wellytomOC/TCC/Figuras/Resultados/TelaResultados.jpeg

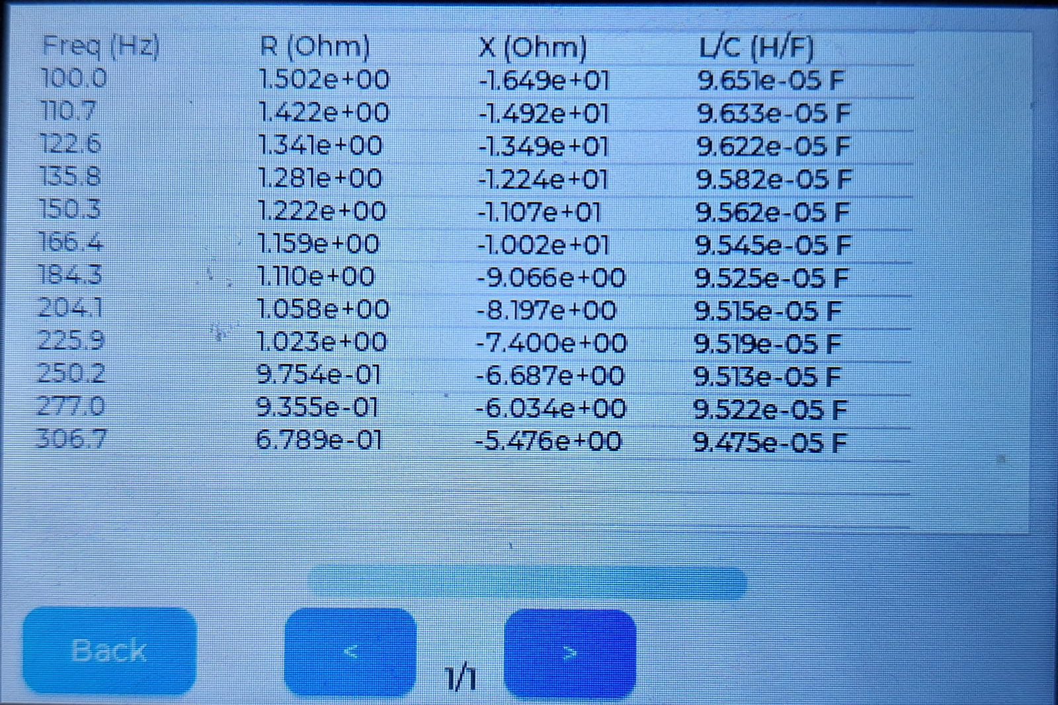
Figuras/Resultados/TelaResultados.jpeg
