wellytomOC/TCC/Figuras/Resultados/TelaMenuPrincipal.jpeg

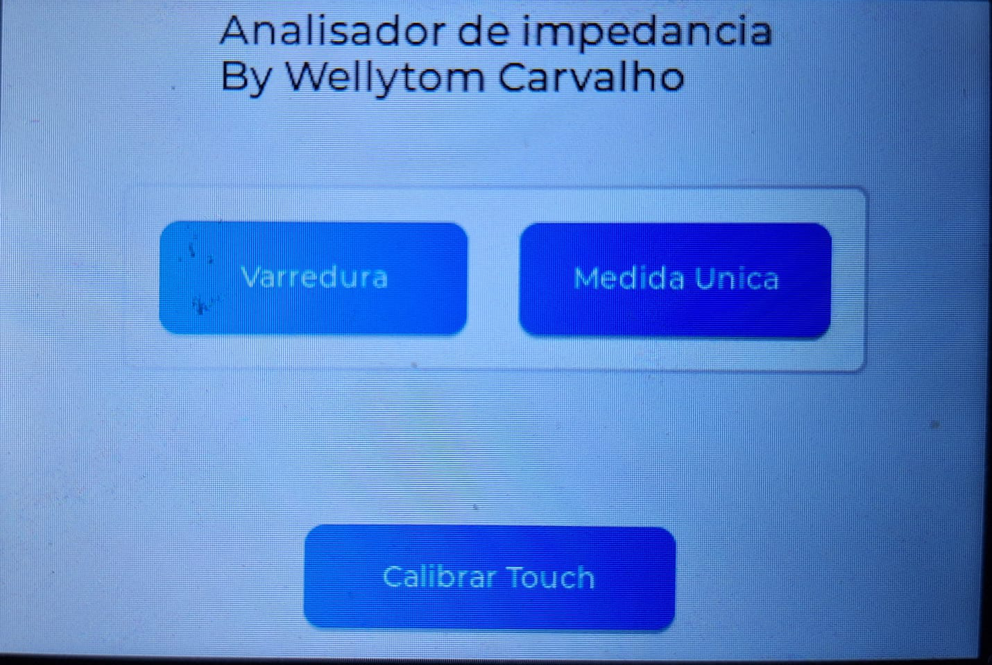
Figuras/Resultados/TelaMenuPrincipal.jpeg
