wellytomOC/TCC/Figuras/fundamentacao/2wire.png

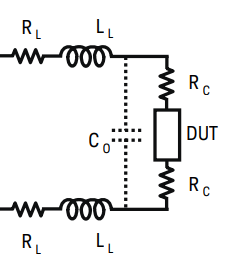
Figuras/fundamentacao/2wire.png
