wellytomOC/TCC/Figuras/fundamentacao/ad5941blockdiagram.png

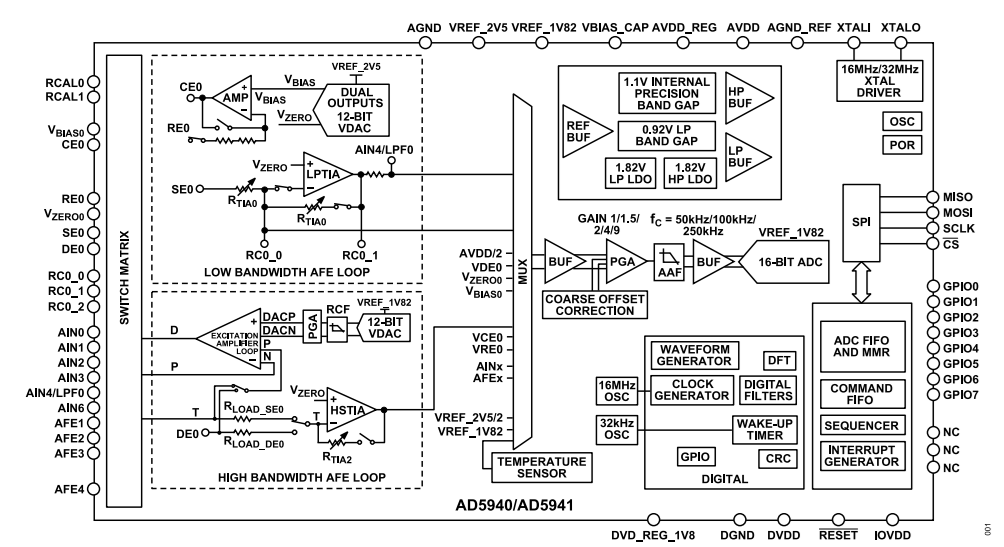
Figuras/fundamentacao/ad5941blockdiagram.png
