wellytomOC/TCC/Figuras/fundamentacao/ADCBLockDiagram.png

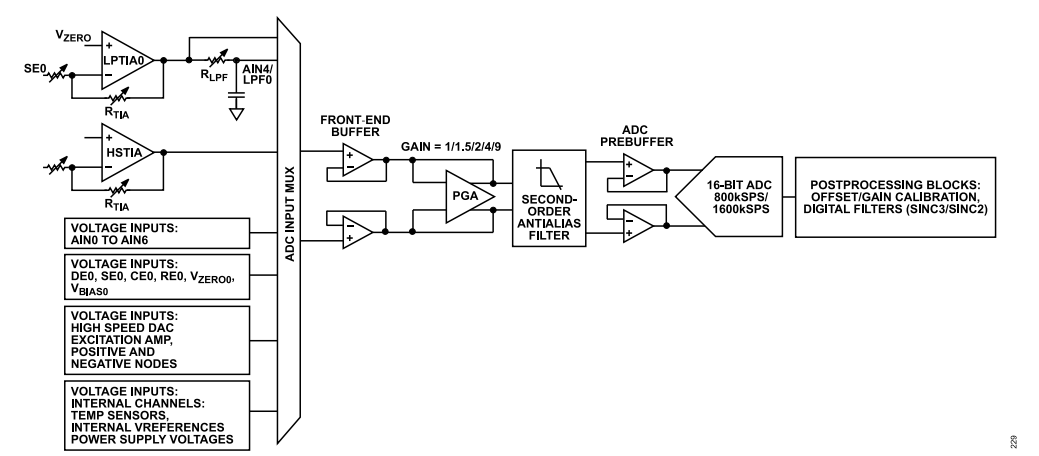
Figuras/fundamentacao/ADCBLockDiagram.png
