wellytomOC/TCC/Figuras/fundamentacao/AutoBalancing.png

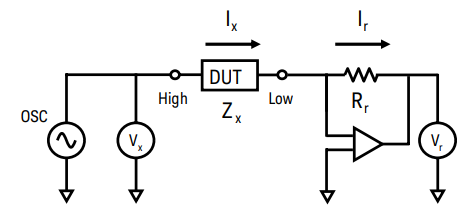
Figuras/fundamentacao/AutoBalancing.png
