wellytomOC/TCC/Figuras/fundamentacao/Bridge method.png

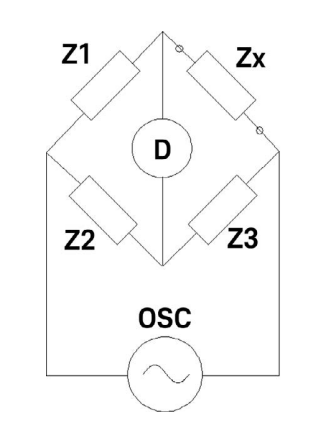
Figuras/fundamentacao/Bridge method.png
