wellytomOC/TCC/Figuras/fundamentacao/Diagrama de impedancia.png

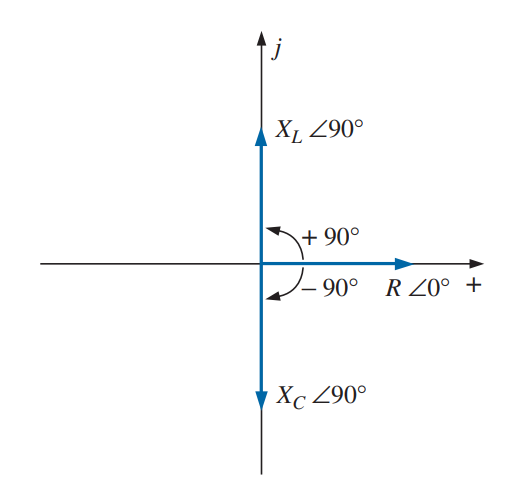
Figuras/fundamentacao/Diagrama de impedancia.png
