wellytomOC/TCC/Figuras/fundamentacao/IVMethod.png

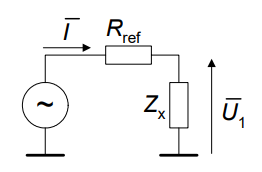
Figuras/fundamentacao/IVMethod.png
