wellytomOC/TCC/Figuras/fundamentacao/LP_loop.png

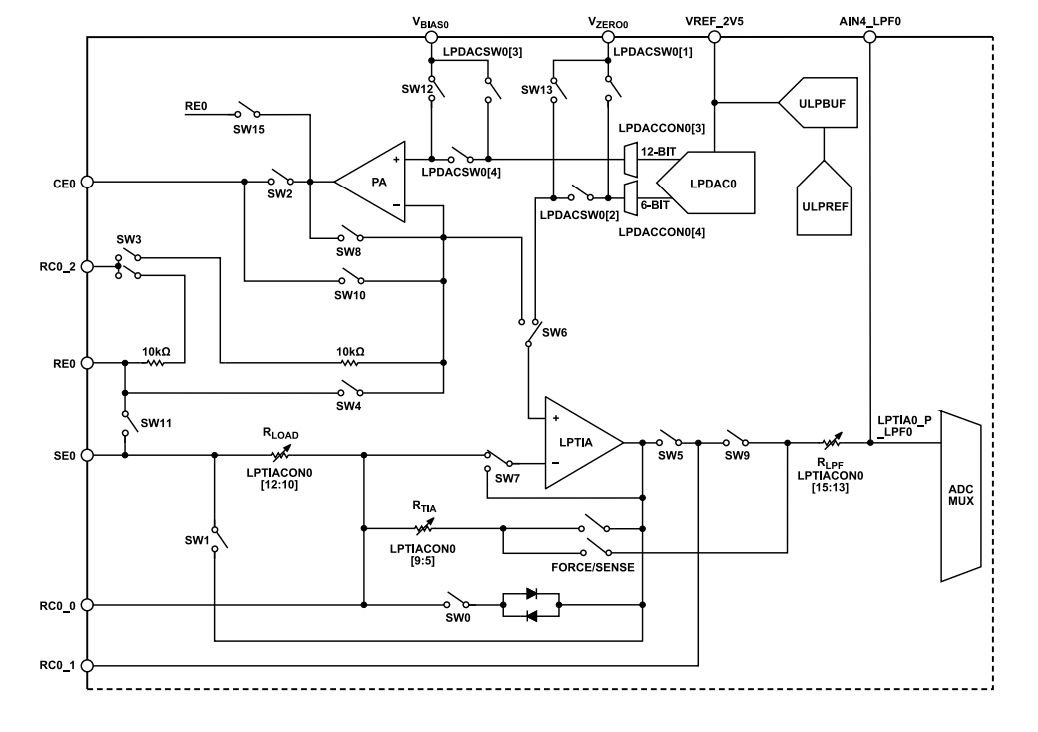
Figuras/fundamentacao/LP_loop.png
