wellytomOC/TCC/Figuras/fundamentacao/PostProcessing.png

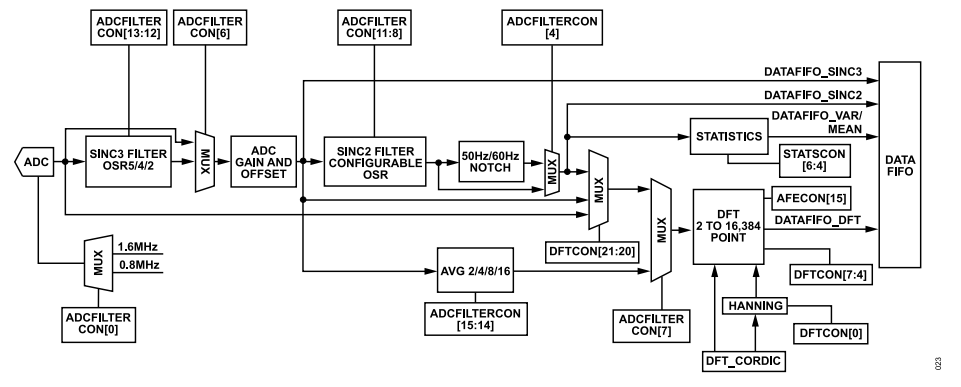
Figuras/fundamentacao/PostProcessing.png
