wellytomOC/TCC/Figuras/fundamentacao/SwitchMatrix.png

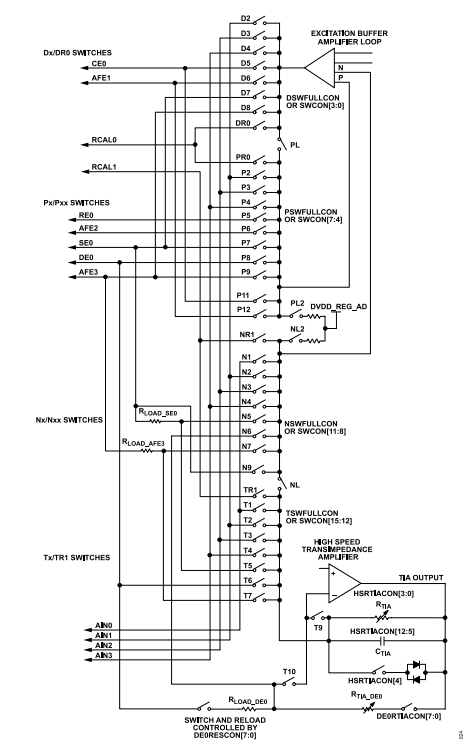
Figuras/fundamentacao/SwitchMatrix.png
