wellytomOC/TCC/Figuras/metodologia/4WireMet.png

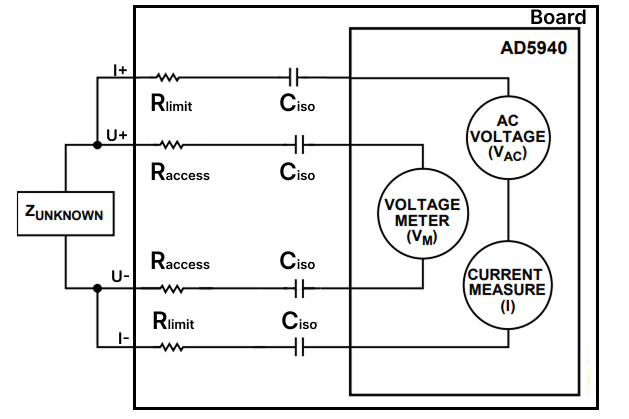
Figuras/metodologia/4WireMet.png
