wellytomOC/TCC/Figuras/metodologia/ClipJacare.jpeg

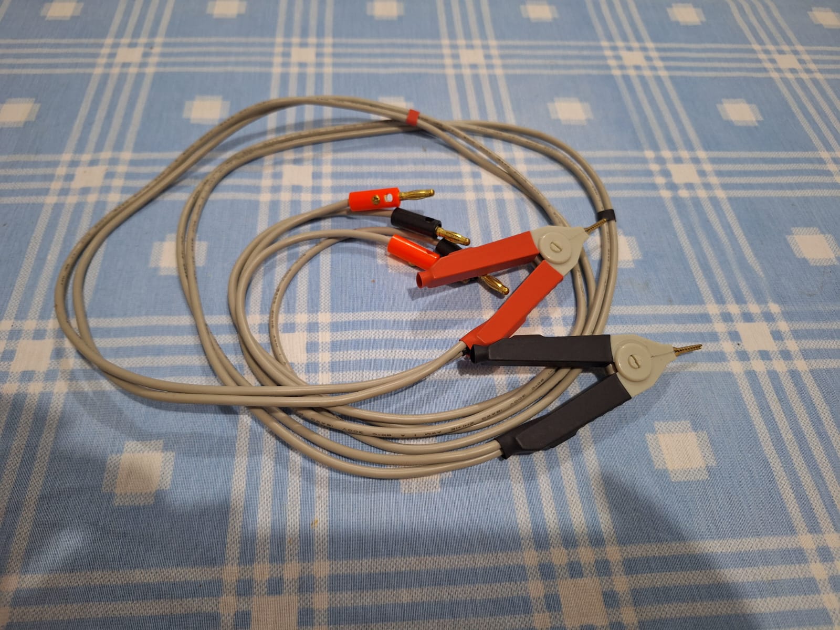
Figuras/metodologia/ClipJacare.jpeg
