wellytomOC/TCC/Figuras/metodologia/DiagramaBlocoGeral.png

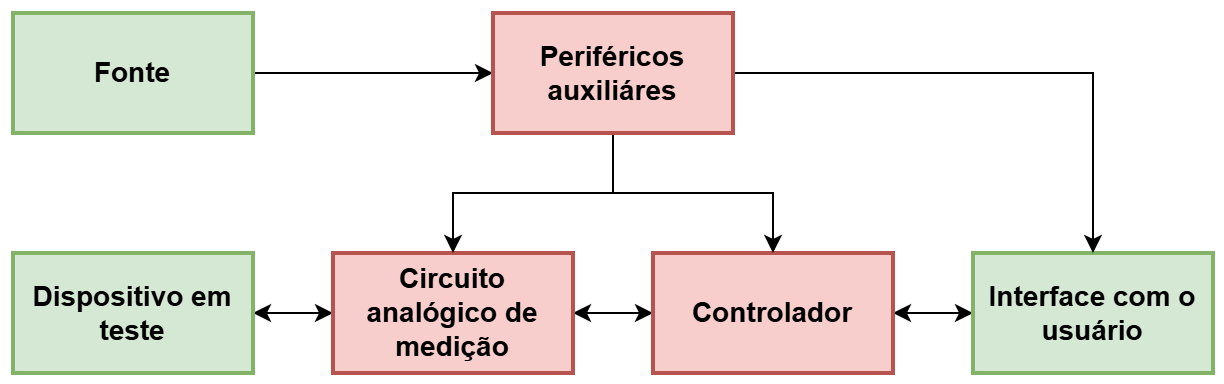
Figuras/metodologia/DiagramaBlocoGeral.png
