wellytomOC/TCC/Figuras/metodologia/DiagramaGeral2.png

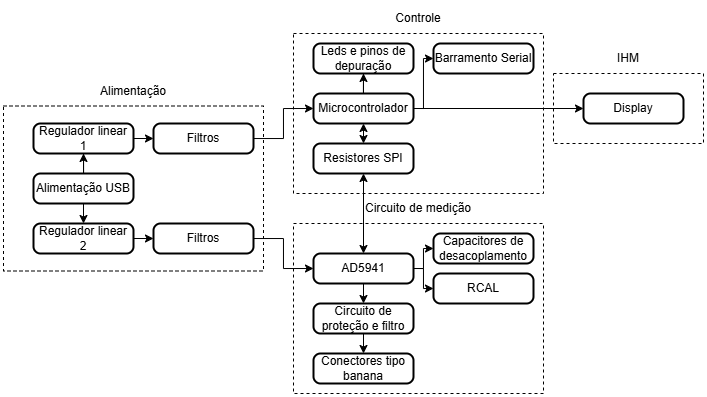
Figuras/metodologia/DiagramaGeral2.png
