wellytomOC/TCC/Figuras/metodologia/Esboco.jpeg

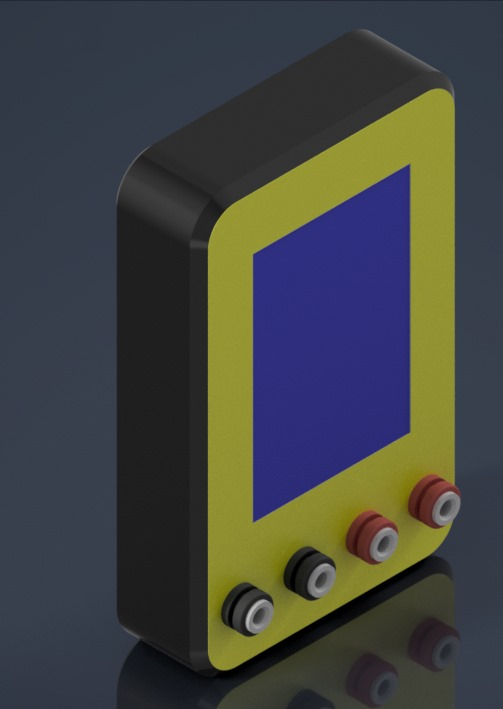
Figuras/metodologia/Esboco.jpeg
