wellytomOC/TCC/Figuras/metodologia/ESP32S3.png

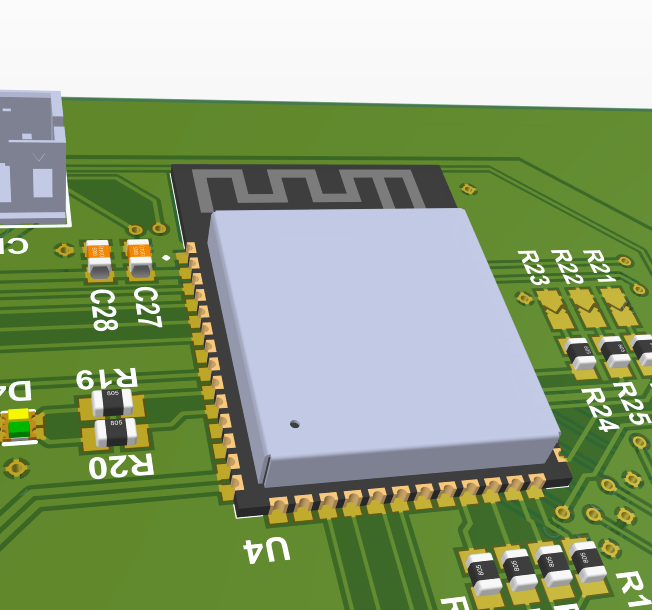
Figuras/metodologia/ESP32S3.png
