wellytomOC/TCC/Figuras/metodologia/fluxoImpedanceMeterTask.png

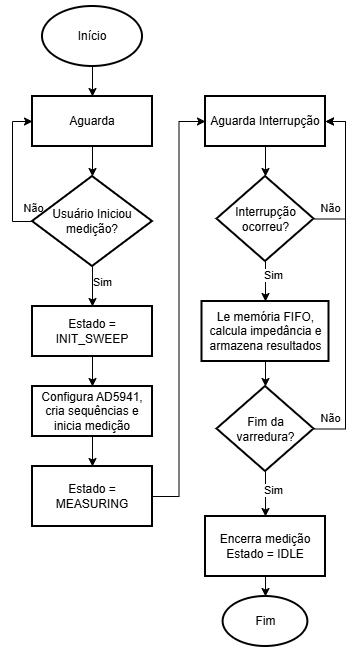
Figuras/metodologia/fluxoImpedanceMeterTask.png
