wellytomOC/TCC/Figuras/metodologia/fluxoSeqInit.png

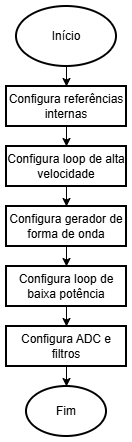
Figuras/metodologia/fluxoSeqInit.png
