wellytomOC/TCC/Figuras/metodologia/fluxoSeqMed.png

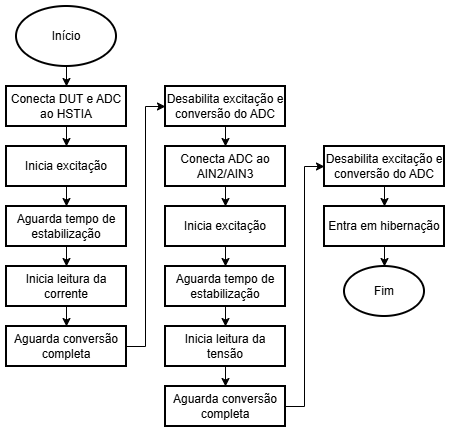
Figuras/metodologia/fluxoSeqMed.png
