wellytomOC/TCC/Figuras/metodologia/fluxoTelas.png

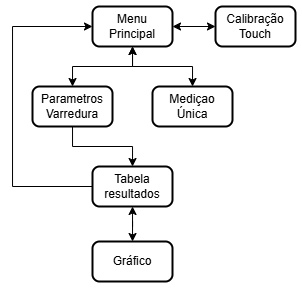
Figuras/metodologia/fluxoTelas.png
