wellytomOC/TCC/Figuras/metodologia/LM1117.png

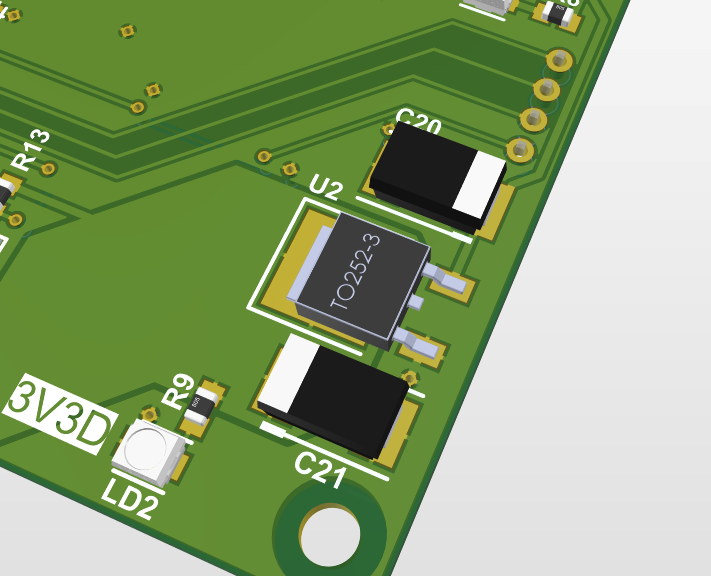
Figuras/metodologia/LM1117.png
