wellytomOC/TCC/Figuras/metodologia/LPFilter.png

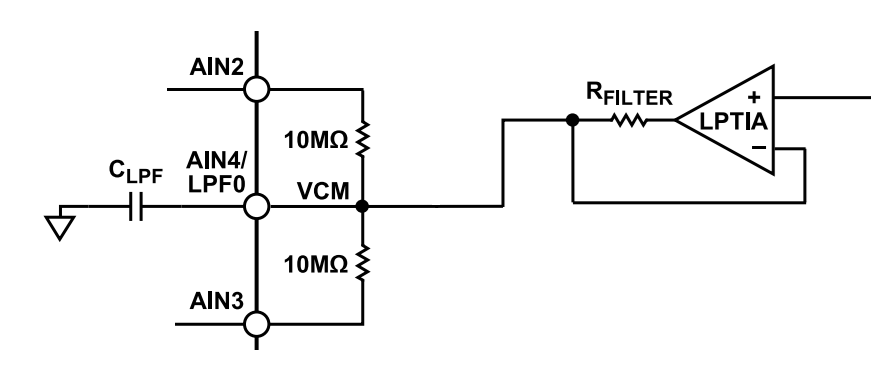
Figuras/metodologia/LPFilter.png
