wellytomOC/TCC/Figuras/metodologia/Rcal.png

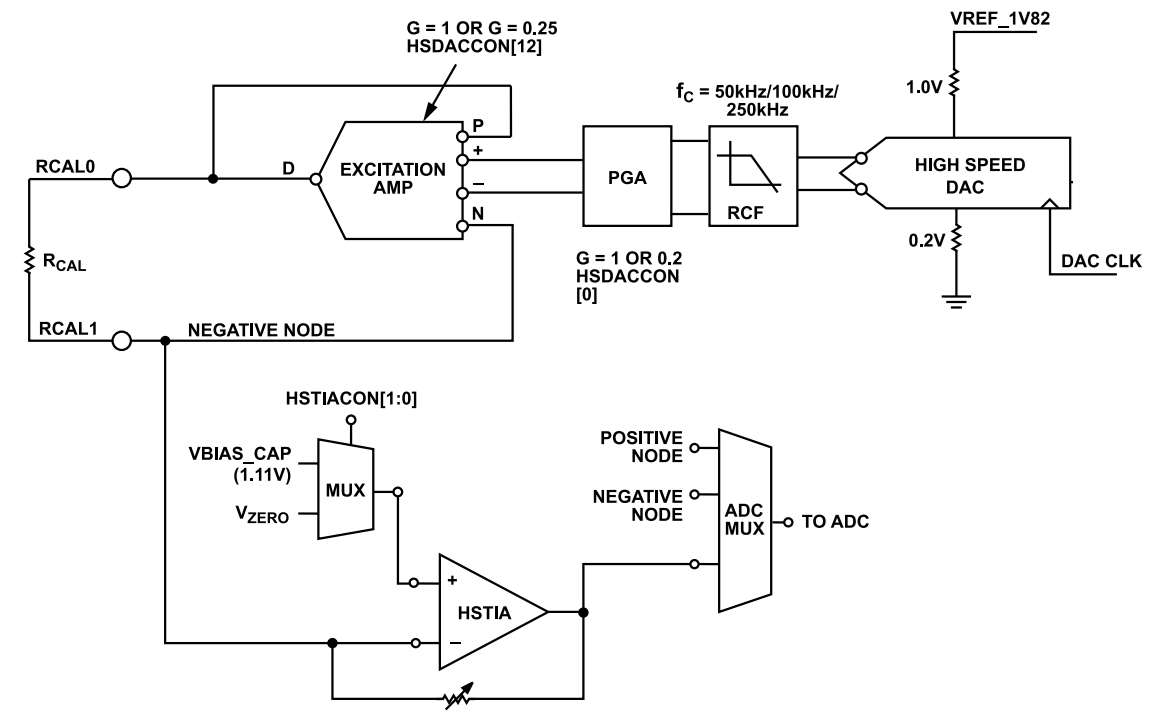
Figuras/metodologia/Rcal.png
