wellytomOC/TCC/Figuras/metodologia/Sequencer.png

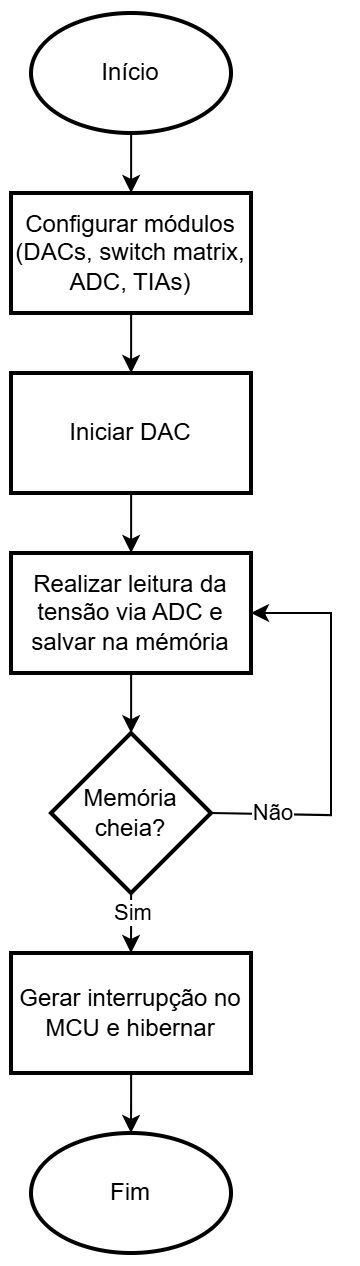
Figuras/metodologia/Sequencer.png
