wellytomOC/TCC/Figuras/metodologia/telas.png

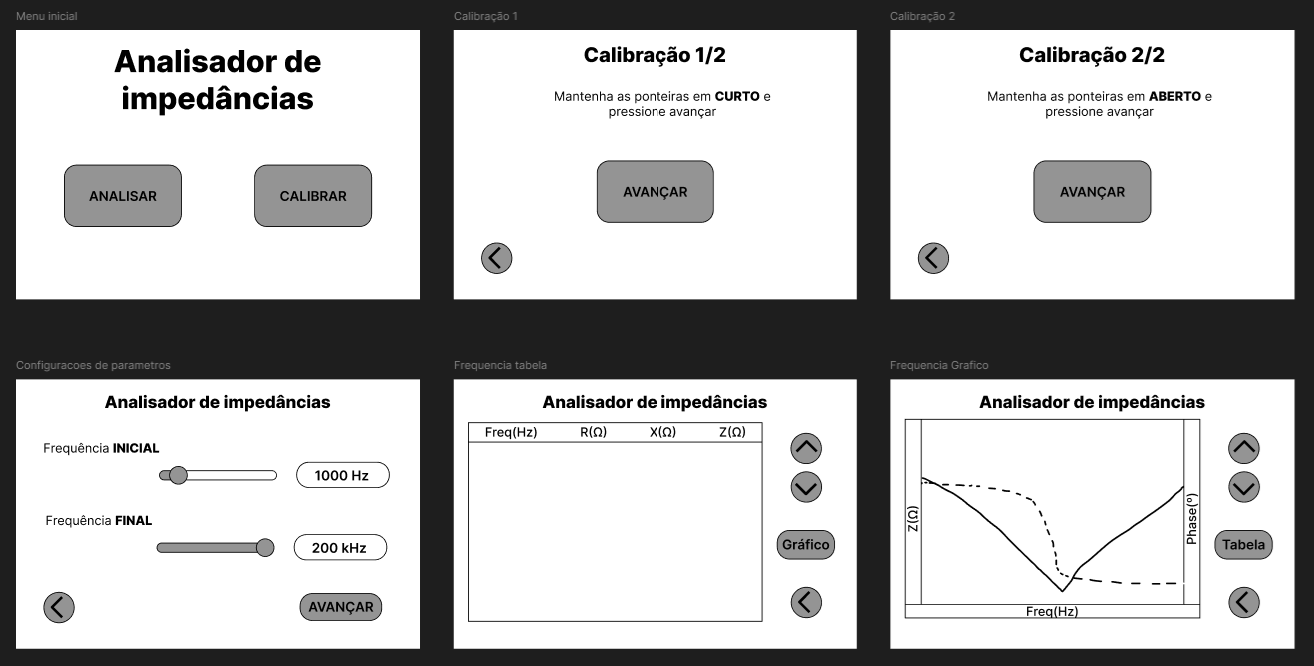
Figuras/metodologia/telas.png
