wellytomOC/TCC/Figuras/metodologia/USB_C.jpeg

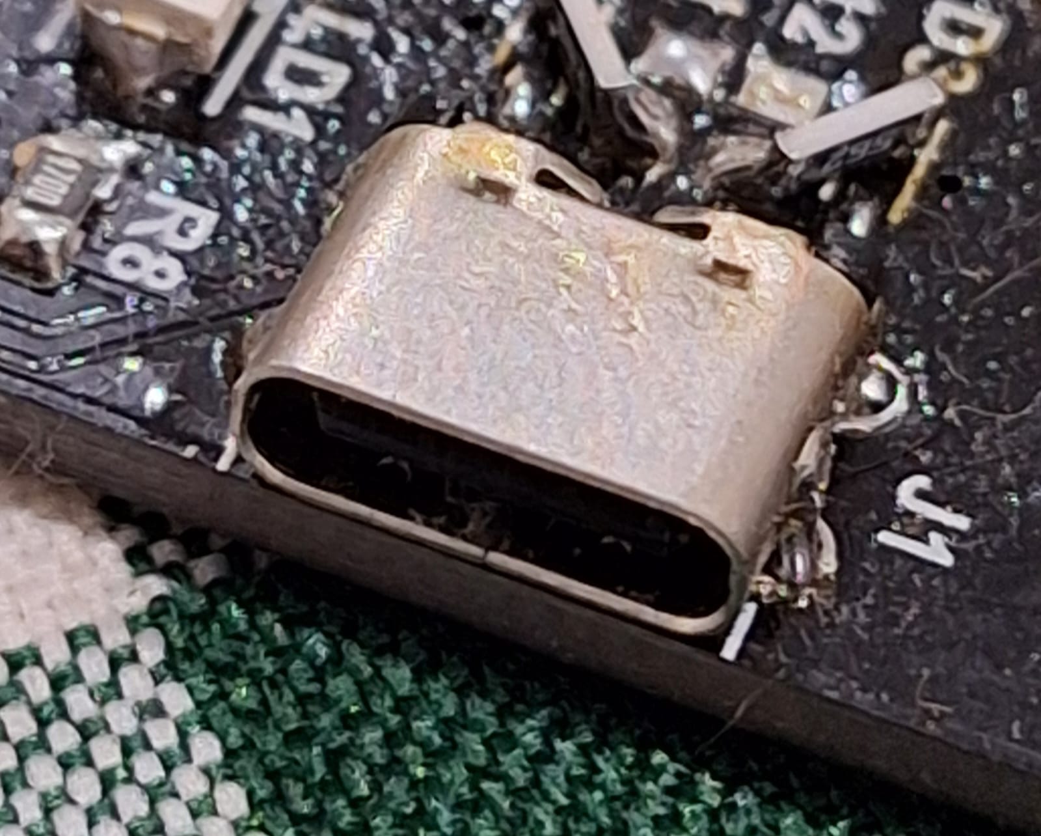
Figuras/metodologia/USB_C.jpeg
