wellytomOC/TCC/Figuras/metodologia/{D1736595-98FE-4F03-B035-AF8B31A85A75}.png

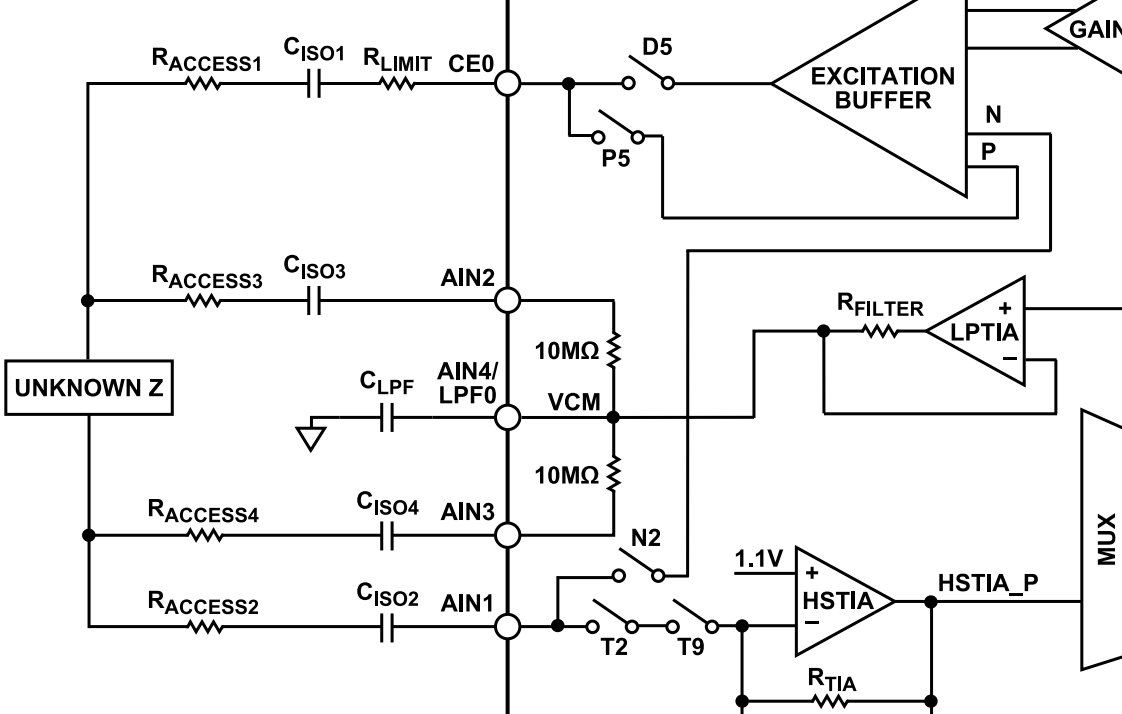
Figuras/metodologia/{D1736595-98FE-4F03-B035-AF8B31A85A75}.png
