wellytomOC/TCC/Ref boards/eval board AD5940/eval-ad5940bioz_bom.xlsx

TITLE: Bill of Materials
BOM NO: 05-049988-01-b.csv
DATE: 11/27/2018
DESIGN: 02_049988a_top
TEMPLATE: Z:\allegro\v172_site\cdssetup\template.bom
CALLOUT: C:\tmp\20_049988b\worklib\02_049988b_top\bom\mech.callouts
ITEM# | Qty | WW_PN | DESCRIPTION | VALUE | JEDEC_TYPE | TOL | VOLTAGE | WATTAGE | LOCATION | MFG | MFG_PN | HLM_STATUS | STOCKROOM_WL | STOCKROOM_GT | STOCKROOM_LK | STOCKROOM_GBO | STOCKROOM_NSH | CUSTOM_PART | DNI
1 | 1 | 08_049988b | PCB | ? | ? | ? | ? | ? | ? | Analog Devices Supplied | 08_049988b | N/A | ? | ? | ? | ? | ? | ? | ?
3 | 2 | E019484 | CONN-PCB TEST POINT BLACK | BLK | CNKEY5001TP | N/A | N/A | N/A | AGND,DGND | VERO TECHNOLOGIES | 20-2137 | REL | N/A | N/A | N/A | N/A | N/A | ? | ?
5 | 3 | E016303 | SWITCH ULTRA SMALL TACTILE | B3U-1000P | SWSML118W98H69 | N/A | N/A | N/A | ARST,PB1,URST | OMRON | B3U-1000P | REL | N/A | N/A | N/A | N/A | 6003208 | ? | ?
6 | 1 | E021979 | CONN-PCB TEST POINT GREEN | GRN | CNKEY5001TP | N/A | N/A | N/A | AVDD | VERO TECHNOLOGIES | 20-313138 | NON-PREF | N/A | N/A | N/A | N/A | N/A | ? | ?
7 | 6 | E028775 | CAP CER X7R | 0.47UF | C0603 | 10 | 25V | N/A | C1,C21,C23,C25,C26,C38 | MURATA | GCM188R71E474KA64D | REL | N/A | N/A | N/A | N/A | 7009886 | ? | ?
8 | 4 | E016510 | CAP CER X5R | 0.1uF | C0402 | 10 | 10V | N/A | C10,C17,C18,C30 | TAIYO YUDEN | LMK105BJ104KV-F | REL | N/A | N/A | N/A | N/A | 7002100 | ? | ?
9 | 1 | E007204 | CAP CER CHIP X8R | 0.1UF | C0603 | 10 | 25V | N/A | C11 | TDK | C1608X8R1E104K080AA | REL | A004-0012-070 | 40302DG460 | N/A | N/A | 7002123 | ? | ?
10 | 1 | E026591 | CAP CER X7R | 1UF | C0603 | 10 | 25V | N/A | C12 | WURTH ELEKTRONIK | 885012000000 | REL | N/A | N/A | N/A | N/A | N/A | ? | ?
11 | 5 | E022682 | CAP CER X5R, GENERAL PURPOSE | 10uF | C0603 | 20 | 10V | N/A | C13,C27,C29,C35,C37 | MURATA | GRM188R61A106ME69D | REL | N/A | N/A | N/A | N/A | N/A | ? | ?
12 | 2 | E020596 | CAP MULTILAYER CER X7R | 1uF | C0603 | 10 | 16V | N/A | C14,C20 | TDK | CGA3E1X7R1C105K080AC | REL | N/A | N/A | N/A | N/A | N/A | ? | ?
14 | 3 | E026762 | CAP CER X5R, GENERAL PURPOSE | 10UF | C0603 | 20 | 35V | N/A | C16,C28,C31 | MURATA | GRM188R6YA106MA73D | REL | N/A | N/A | N/A | N/A | N/A | ? | ?
15 | 2 | E031299 | CAP CER X7R | 0.1UF | C0603 | 5 | 50V | N/A | C19,C32 | AVX CORPORATION | 06035C104J4Z2A | REL | N/A | N/A | N/A | N/A | N/A | ? | ?
16 | 1 | E010382 | CAP CER X5R, GENERAL PURPOSE | 4.7uF | C0603 | 10 | 6.3V | N/A | C22 | MURATA | GRM188R60J475KE19 | NON-PREF | N/A | N/A | N/A | 1391_CAB3 | 7003191 | ? | ?
18 | 2 | E022722 | CAP CER X5R, GENERAL PURPOSE | 0.1uF | C0201 | 10 | 10V | N/A | C3,C4 | MURATA | GRM033R61A104KE84D | REL | N/A | N/A | N/A | N/A | N/A | ? | ?
19 | 2 | E000408 | CAP CER NP0 | 6.8PF | C0603 | 5 | 50V | N/A | C33,C34 | PHYCOMP (YAGEO) | 2238 867 15688 | REL | ADD_TO_STOCK_#21 | N/A | 721943 | N/A | 7003409 | ? | ?
22 | 1 | E007908 | CAP CER C0G(NP0), GENERAL PURPOSE | 0.001uF | C0603 | 5 | 50V | N/A | C6 | MURATA | GRM1885C1H102JA01D | REL | N/A | N/A | N/A | N/A | N/A | ? | ?
23 | 1 | E024105 | CAP CER X5R, GENERAL PURPOSE | 0.47UF | C0201 | 20 | 6.3V | N/A | C66 | MURATA | GRM033R60J474ME90 | REL | N/A | N/A | N/A | N/A | N/A | ? | ?
24 | 1 | E023542 | CAP MULTILAYER CER CHIP, C0G | 0.015uF | C0603 | 5 | 25V | N/A | C68 | KEMET | C0603C153J3GACTU | REL | N/A | N/A | N/A | N/A | N/A | ? | ?
25 | 1 | E030749 | CAP CER X7S, GENERAL PURPOSE | 4.7UF | C0603 | 10 | 10V | N/A | C7 | TDK | C1608X7S1A475K080AC | REL | N/A | N/A | N/A | N/A | N/A | ? | ?
26 | 2 | E032601 | CAP CER C0G (NP0), GENERAL PURPOSE | 4700PF | C0603 | 1 | 50V | N/A | C8,CLPF | KEMET | C0603C472F5GACTU | REL | N/A | N/A | N/A | N/A | N/A | ? | ?
27 | 1 | E030552 | CAP CER C0G, COMMERCIAL GRADE | 6800PF | C0603 | 1 | 25V | N/A | C9 | KEMET | C0603C682F3GACTU | REL | N/A | N/A | N/A | N/A | N/A | ? | ?
29 | 1 | E000417 | CAP CER NPO | 220pF | C0603 | 5 | 50V | N/A | CTIA | YAGEO | CC0603JRNPO9BN221 | REL | A004-0012-074 | N/A | 430948 | N/A | 7002874 | ? | ?
30 | 1 | E026047 | DIODE TVS ARRAY, LOW CAPACITANCE ESD PROTECTION | SP3004-04XTG | SOT-563 | N/A | 6V | N/A | D4 | LITTELFUSE, INC. | SP3004-04XTG | REL | N/A | N/A | N/A | N/A | N/A | ? | ?
31 | 2 | E014445 | LED LOW CURRENT (GREEN) | SML-P11MTT86 | LED0402 | N/A | N/A | 0.054W | DS1,DS3 | ROHM | SML-P11MTT86 | REL | N/A | N/A | N/A | N/A | N/A | ? | ?
32 | 2 | E019485 | CONN-PCB TEST POINT RED | RED | CNKEY5001TP | N/A | N/A | N/A | DVDD,IOVDD | VERO TECHNOLOGIES | 20-313137 | REL | N/A | N/A | N/A | N/A | 6001481 | ? | ?
33 | 1 | E002349 | IND FERRITE BD | BLM41A800SPB-1806 | L1806 | N/A | N/A | N/A | E1 | MURATA | BLM41A800SPB-1806 | REL | A047-0002-001 | 40360DG002 | N/A | N/A | 7005351 | ? | ?
34 | 1 | E028908 | IND FERRITE BEAD, 0.150OHM MAX DCR, 1A | 600OHM AT 100MEGHZ | L0603 | 25 | N/A | N/A | E4 | TDK | MPZ1608S601ATA00 | REL | N/A | N/A | N/A | N/A | N/A | ? | ?
35 | 8 | E019487 | CONN-PCB HEADER 1ROW 2WAY | M20-9990245 | CNHARWIN-M20-9990246 | N/A | N/A | N/A | GP0,GP1,GP2,GP3,GP4,GP5,GP6,GP7 | HARWIN | M20-9990245 | REL | N/A | N/A | N/A | N/A | N/A | ? | ?
36 | 3 | E026603 | CONN-PCB 6POS MALE UNSHROUDED HDR 0.64MM SQ POST, 2.54MM PITCH, 6MM POST HEIGHT, 3MM SOLDER TAIL, FOR CN6P_JMPRSHRT ADD 3X M000385 | 61300621121 | CNHDR2X3H346 | N/A | N/A | N/A | JP1,JP2,JP3 | WURTH ELEKTRONIK | 61300621121 | REL | N/A | N/A | N/A | N/A | N/A | ? | ?
37 | 2 | E019487 | CONN-PCB JMPR ST MALE 2P,1X M020779 | M20-9990245 | CNHARWIN-M20-9990246 | N/A | N/A | N/A | JP8,JP13 | HARWIN | M20-9990245 | REL | N/A | N/A | N/A | N/A | N/A | ? | ?
38 | 1 | E018034 | CONN-PCB HEADER 2.0MM P LOW PROFILE | TMM-103-01-L-D-SM | CNHDR2X3H235 | N/A | N/A | N/A | JP7 | SAMTEC | TMM-103-01-L-D-SM | REL | N/A | N/A | N/A | N/A | 6002380 | ? | ?
39 | 1 | E020477 | CONN-PCB RCPT 25MIL SQ POST 2.54MM PITCH | SSQ-106-03-G-S | CNSAMTECSSQ-106-XX-X-S | N/A | N/A | N/A | P1 | SAMTEC | SSQ-106-03-G-S | REL | N/A | N/A | N/A | N/A | N/A | ? | ?
40 | 8 | E017879 | CONN-PCB HDR SIL VERT, 2.0MM PITCH | M22F2010305 | CNHDR1X3H207 | N/A | N/A | N/A | P7,P9,P10,P13,P14,P15,P16,P17 | HARWIN | M22F2010305 | REL | N/A | N/A | N/A | N/A | 6002144 | ? | ?
41 | 2 | E016527 | CONN-PCB TERM BLOCK 3.5MM P | 25.195.0253.0 | CNWIELAND0253 | N/A | N/A | N/A | P8,P11 | WIELAND ELECTRIC GMBH | 25.195.0253.0 | REL | N/A | N/A | N/A | N/A | 6001063 | ? | ?
42 | 3 | E023091 | CONN-PCB HDR SIL VERT, 2.0MM PITCH | M22-2010205 | CNHDR1X2H207 | N/A | N/A | N/A | P5,P12,P20 | HARWIN | M22-2010205 | REL | N/A | N/A | N/A | N/A | N/A | ? | ?
44 | 2 | E020478 | CONN-PCB RCPT 25MIL SQ POST 2.54MM P | SSQ-108-03-G-S | CNSAMTECSSQ-108-XX-X-S | N/A | N/A | N/A | P2,P4 | SAMTEC | SSQ-108-03-G-S | REL | N/A | N/A | N/A | N/A | N/A | ? | ?
45 | 1 | E020479 | CONN-PCB RCPT 25MIL SQ POST 2.54MM PITCH | SSQ-110-03-G-S | CNSAMTECSSQ-110-XX-X-S | N/A | N/A | N/A | P3 | SAMTEC | SSQ-110-03-G-S | REL | N/A | N/A | N/A | N/A | N/A | ? | ?
46 | 1 | E023846 | CONN-PCB MICROUSB RECEPTACLE | 47346-0001 | CNMOLEX47346-0001 | N/A | N/A | N/A | P6 | MOLEX | 47346-0001 | REL | N/A | N/A | N/A | N/A | N/A | ? | ?
47 | 2 | E027148 | RES STANDARD THICK FILM CHIP | 0 | R0603 | N/A | N/A | 1/4W | R1,R13 | VISHAY | CRCW06030000Z0EAHP | REL | N/A | N/A | N/A | N/A | 7008613 | ? | ?
48 | 7 | E019640 | RES STD THICK FILM CHIP | 10K | R0402 | 5 | N/A | 1/16W | R3,R4,R5,R10,R16,R21,R100 | VISHAY | CRCW040210K0JNED | REL | N/A | N/A | N/A | N/A | 7000280 | ? | ?
49 | 1 | E014042 | RES STD THICK FILM CHIP | 17.4K | R0402 | 1 | N/A | 1/16W | R11 | VISHAY | CRCW040217K4FKED | REL | N/A | N/A | N/A | 1594_CAB3 | 7006318 | ? | ?
50 | 2 | E010661 | RES THICK FILM CHIP | 0 | R0402 | 1 | 50V | 1/16W | R9,R12 | MULTICOMP (SPC) | MC00625W040210R | REL | N/A | N/A | N/A | N/A | 7001777 | ? | ?
51 | 1 | E029463 | RES GEN PURPOSE CHIP | 5.1MEG | R0201 | 1 | N/A | 1/20W | R14 | SAMSUNG | RC0603F515CS | REL | N/A | N/A | N/A | N/A | N/A | ? | ?
52 | 8 | E004207 | RES FILM SMD 0603 | 0 | R0603 | 1 | N/A | 1/16W | R15,R27,R30,R34,R36,R51,R52,R53 | MULTICOMP (SPC) | MC0603WG00000T5E-TC | REL | A003-0032-130 | N/A | 772-227 | N/A | N/A | ? | ?
53 | 1 | E011856 | RES FILM CHIP THICK | 3MEG | R0603 | 1 | N/A | 1/10W | R17 | VISHAY | CRCW06033M00FKEA | REL | N/A | N/A | N/A | N/A | 7007465 | ? | ?
55 | 1 | E025456 | RES THIN FILM CHIP, HIGH RELIABILITY | 1K | R0603 | 0.1 | N/A | 1/10W | R19 | PANASONIC | ERA-3ARB102V | REL | N/A | N/A | N/A | N/A | N/A | ? | ?
56 | 1 | E003682 | RES PRECISION THICK FILM CHIP R0603 | 1MEG | R0603 | 1 | N/A | 1/10W | R20 | PANASONIC | ERJ-3EKF1004V | REL | A003-0032-017 | 41816DG307 | FEC 911-598 | N/A | N/A | ? | ?
57 | 1 | E003672 | RES PRECISION THICK FILM CHIP R0603 | 150K | R0603 | 1 | N/A | 1/10W | R22 | PANASONIC | ERJ-3EKF1503V | REL | A003-0032-007 | 41816JH1675 | N/A | N/A | 7001838 | ? | ?
58 | 2 | E020465 | RES GEN PURPOSE CHIP | 10MEG | R0402 | 1 | N/A | 1/16W | R23,R46 | YAGEO | RC0402FR-0710ML | REL | N/A | N/A | N/A | N/A | N/A | ? | ?
59 | 2 | E017481 | RES THICK FILM CHIP | 2.2 | R0603 | 1 | N/A | 1/10W | R24,R26 | PANASONIC | ERJ-3RQF2R2V | REL | N/A | N/A | N/A | N/A | 7006528 | ? | ?
65 | 1 | E004244 | RES FILM SMD 0603 | 560K | R0603 | 1 | N/A | 1/16W | R37 | MULTICOMP (SPC) | MC 0.063W 0603 1% 560K. | REL | ADD_TO_STOCK_191 | N/A | 911-562 | N/A | 7008073 | ? | ?
66 | 1 | E003749 | RES PRECISION THICK FILM CHIP | 1MEG | R0402 | 1 | N/A | 1/10W | R39 | PANASONIC | ERJ-2RKF1004X | REL | A003-0035-002 | N/A | N/A | 1686_CAB3 | N/A | ? | ?
67 | 2 | E005790 | RESISTOR 0603 | 10MEG | R0603 | 5 | N/A | 1/10W | R8,R40 | ROHM | MCR03EZPJ106 | REL | A003-0038-015 | N/A | N/A | N/A | 7005920 | ? | ?
68 | 2 | E024299 | RES METAL FILM HIGH REL | 300K | R0603 | 0.1 | N/A | 1/10W | R41,R45 | PANASONIC | ERA-3AEB304V | REL | N/A | N/A | N/A | N/A | N/A | ? | ?
69 | 1 | E015180 | RES THICK FILM CHIP | 1K | R0603 | 1 | N/A | 1/4W | R43 | VISHAY | CRCW06031K00FKEAHP | REL | N/A | N/A | N/A | N/A | 7006446 | ? | ?
70 | 1 | E026533 | RES GENERAL PURPOSE | 510K | R0603 | 1 | N/A | 1/10W | R44 | YAGEO | RC0603FR-07510KL | REL | N/A | N/A | N/A | N/A | N/A | ? | ?
71 | 4 | E003438 | RES CHIP SMD JMPR | 0 | R0402 | 5 | N/A | N/A | R47,R48,R49,R50 | PANASONIC | ERJ-2GE0R00X | REL | A003-0021-001 | N/A | N/A | 1138_CAB3 | 7000282 | ? | ?
72 | 1 | E004245 | RES THICK FILM CHIP | 560 | R0603 | 1 | N/A | 1/16W | R6 | MULTICOMP (SPC) | MC0063W06031560R | REL | N/A | N/A | N/A | N/A | N/A | ? | ?
74 | 1 | E030120 | RES PRECION THICK FILM CHIP | 300K | R0402 | 0.1 | N/A | 1/10W | R81 | PANASONIC | ERJ-2RKF3003X | REL | N/A | N/A | N/A | N/A | N/A | ? | ?
76 | 1 | E029951 | RES METAL FILM, HIGH RELIABILITY, AUTOMOTIVE GRADE | 10K | R0603 | 0.1 | N/A | 1/10W | RCAL | PANASONIC | ERA-3ARB103V | REL | N/A | N/A | N/A | N/A | N/A | ? | ?
78 | 1 | E021452 | IC I2C-COMPATIBLE (2WIRE) SERIAL EEPROM 32KBIT | AT24C32E-SSHM | SO8 | N/A | N/A | ? | U1 | ATMEL | AT24C32E-SSHM | REL | N/A | N/A | N/A | N/A | N/A | ? | ?
79 | 1 | E025515 | IC-ADI 600MA, ULTRALOW NOISE, HIGH PSRR, RF LINEAR REG, 1.2 TO 3.4 VOUT | ADM7155ACPZ-04 | DFN8_3X3_PAD2_44X1_6_A | N/A | N/A | ? | U2 | ANALOG DEVICES | ADM7155ACPZ-04-R7 | REL | N/A | N/A | N/A | N/A | N/A | ? | ?
80 | 1 | E027747 | IC-ADI HIGH PRECISION,BIO-IMPERDAMCE AMD ELECTROCHEMICAL FRONT END PRELIM | AD5940 | WLCSP56 | N/A | N/A | ? | U3 | ANALOG DEVICES | AD5940 | RWC | N/A | N/A | N/A | N/A | N/A | ? | ?
81 | 1 | E020094 | IC-ADI ULTRA LOW QUIESCENT I, CMOS LIN REG | ADP160AUJZ-3.3 | TSOT-5 | N/A | N/A | ? | U4 | ANALOG DEVICES | ADP160AUJZ-3.3-R7 | REL | N/A | N/A | N/A | N/A | N/A | ? | ?
82 | 1 | E024534 | IC-ADI SINGLE-LEAD HEART RATE MONITOR FRONT END PRELIM | AD8233 | WLCSP20_D | N/A | N/A | ? | U5 | ANALOG DEVICES | AD8233 | RWC | N/A | N/A | N/A | N/A | N/A | ? | ?
83 | 1 | E029612 | IC CRYSTAL ULTRA MINIATURE CERAMIC SMD | 16MEGHZ | YSML126W98H31 | 10PPM | N/A | N/A | Y1 | ABRACON CORP. | ABM8-16.000MHZ-7-1-U-T | REL | N/A | N/A | N/A | N/A | N/A | ? | ?
Callouts File:C:\tmp\20_049988b\worklib\02_049988b_top\bom\mech.callouts
Mechanical Parts
ITEM# | Qty | WW_PN | DESCRIPTION | VALUE | JEDEC_TYPE | TOL | VOLTAGE | WATTAGE | LOCATION | MFG | MFG_PN | HLM_STATUS | STOCKROOM_WL | STOCKROOM_GT | STOCKROOM_LK | STOCKROOM_GBO | STOCKROOM_NSH | CUSTOM_PART | DNI
2 | 10 | M020779 | SHUNT, 2POS .100 LOPRO TIN | ? | N/A | ? | ? | ? | ? | FCI | 68786-302LF | REL | N/A | N/A | N/A | N/A | N/A | ? | ?
3 | 3 | M031257 | SHUNT, 2MM PITCH CONNECTOR JUMPER OPEN TOP, GRIP | ? | N/A | ? | ? | ? | ? | SULLINS | NPN02SXLN-RC | REL | N/A | N/A | N/A | N/A | N/A | ? | ?
4 | 4 | M025339 | SCREW, MACHINE NYLON PAN HEAD PHILLIPS 4-40 THREAD, 1/4 INCH LONG | ? | N/A | ? | ? | ? | ? | B&F FASTENER SUPPLY | NY PMS 440 0025 PH | REL | N/A | N/A | N/A | N/A | N/A | ? | ?
5 | 4 | M025474 | STANDOFF, NYLON HEX FEMALE 6.35MM O.D, 4-40 THREAD, 1/2 INCH LONG | ? | N/A | ? | ? | ? | ? | KEYSTONE | 1902C | REL | N/A | N/A | N/A | N/A | N/A | ? | ?
6 | 9 | M000385 | SOCKET, 0.100, MINI-JUMP ASSY | ? | N/A | ? | ? | ? | ? | FCI | 65474-001LF | REL | A011-0002-038 | N/A | N/A | N/A | N/A | ? | ?
The following components are part of the PCB or are NOT to be installed
ITEM# | Qty | WW_PN | DESCRIPTION | VALUE | JEDEC_TYPE | TOL | VOLTAGE | WATTAGE | LOCATION | MFG | MFG_PN | HLM_STATUS | STOCKROOM_WL | STOCKROOM_GT | STOCKROOM_LK | STOCKROOM_GBO | STOCKROOM_NSH | CUSTOM_PART | DNI
2 | 19 | E019485 | CONN-PCB TEST POINT RED | RED | CNKEY5001TP | N/A | N/A | N/A | AFE1,AIN0,AIN1,AIN2,AIN3,AIN4,CE0,DE0,ECG,ECGN,ECGP,F+,F-,RE0,S+,S-,SE0,VBIAS,VZERO | VERO TECHNOLOGIES | 20-313137 | REL | N/A | N/A | N/A | N/A | 6001481 | ? | DNI
4 | 2 | E019484 | CONN-PCB TEST POINT BLACK | BLK | CNKEY5001TP | N/A | N/A | N/A | AGND1,DGND1 | VERO TECHNOLOGIES | 20-2137 | REL | N/A | N/A | N/A | N/A | N/A | ? | DNI
13 | 3 | E000381 | DO NOT INSTALL (TBD_C0402), PLEASE USE SYM_3 AND/OR SYM_4 | TBD0402 | C0402 | TBD0402 | TBD0402 | N/A | C2,C15,C36 | TBD0402 | TBD0402 | REL | TBD0402 | N/A | N/A | N/A | N/A | ? | DNI
17 | 1 | E018707 | CAP CER X7R | 0.1uF | C0402 | 10 | 16V | N/A | C24 | KEMET | C0402C104K4RACTU | REL | N/A | N/A | N/A | N/A | 7002106 | ? | DNI
20 | 1 | E017265 | CAP CER C0G | 470pF | C0603 | 5 | 25V | N/A | C39 | AVX | 06033A471JAT2A | REL | N/A | N/A | N/A | N/A | N/A | ? | DNI
21 | 1 | E028775 | CAP CER X7R | 0.47UF | C0603 | 10 | 25V | N/A | C5 | MURATA | GCM188R71E474KA64D | REL | N/A | N/A | N/A | N/A | 7009886 | ? | DNI
28 | 1 | E007959 | CAP ULTRALOW ESR NP0 CHIP C0603 | 47pF | C0603 | 5 | 100V | N/A | CHSTIA | AVX | 06031U470JAT2A | REL | A004-0012-077 | 40302DG785 | N/A | N/A | 7003255 | ? | DNI
43 | 2 | E017879 | CONN-PCB HDR SIL VERT, 2.0MM PITCH | M22F2010305 | CNHDR1X3H207 | N/A | N/A | N/A | P18,P19 | HARWIN | M22F2010305 | REL | N/A | N/A | N/A | N/A | 6002144 | ? | DNI
54 | 1 | E024299 | RES METAL FILM HIGH REL | 300K | R0603 | 0.1 | N/A | 1/10W | R18 | PANASONIC | ERA-3AEB304V | REL | N/A | N/A | N/A | N/A | N/A | ? | DNI
60 | 2 | E020465 | RES GEN PURPOSE CHIP | 10MEG | R0402 | 1 | N/A | 1/16W | R25,R42 | YAGEO | RC0402FR-0710ML | REL | N/A | N/A | N/A | N/A | N/A | ? | DNI
61 | 3 | E028311 | RES TBD R0805_R0603_TH200LD25 COMBO, PLEASE USE SYM_3 AND/OR SYM_4 | R0805_R0603_TH200LD25 | R0805_0603_TH200LD25 | N/A | N/A | N/A | R28,R29,R31 | N/A | TBD | REL | N/A | N/A | N/A | N/A | N/A | ? | DNI
62 | 2 | E004050 | DO NOT INSTALL (TBD_R0603), PLEASE USE SYM_3 AND/OR SYM_4 | TBD0603 | R0603 | TBD0603 | N/A | TBD0603 | R32,RHSTIA | TBD0603 | TBD0603 | REL | TBD0603 | N/A | N/A | N/A | N/A | ? | DNI
63 | 1 | E018430 | RES THICK FILM CHIP | 100K | R0603 | 1 | N/A | 1/16W | R33 | MULTICOMP (SPC) | MC 0.063W 0603 1% 100K | REL | N/A | N/A | N/A | N/A | N/A | ? | DNI
64 | 2 | E004207 | RES FILM SMD 0603 | 0 | R0603 | 1 | N/A | 1/16W | R35,R38 | MULTICOMP (SPC) | MC0603WG00000T5E-TC | REL | A003-0032-130 | N/A | 772-227 | N/A | N/A | ? | DNI
73 | 1 | E027148 | RES STANDARD THICK FILM CHIP | 0 | R0603 | N/A | N/A | 1/4W | R7 | VISHAY | CRCW06030000Z0EAHP | REL | N/A | N/A | N/A | N/A | 7008613 | ? | DNI
75 | 1 | E004244 | RES FILM SMD 0603 | 560K | R0603 | 1 | N/A | 1/16W | R82 | MULTICOMP (SPC) | MC 0.063W 0603 1% 560K. | REL | ADD_TO_STOCK_191 | N/A | 911-562 | N/A | 7008073 | ? | DNI
77 | 1 | E003666 | RES PRECISION THICK FILM CHIP R0603 | 10 | R0603 | 1 | N/A | 1/10W | RTIA | PANASONIC | ERJ-3EKF10R0V | REL | A003-0032-001 | 41816DG315 | FEC 910-995 | N/A | 7005634 | ? | DNI
