wellytomOC/TCC/altium/TCC01_v2/PCB2_0.step

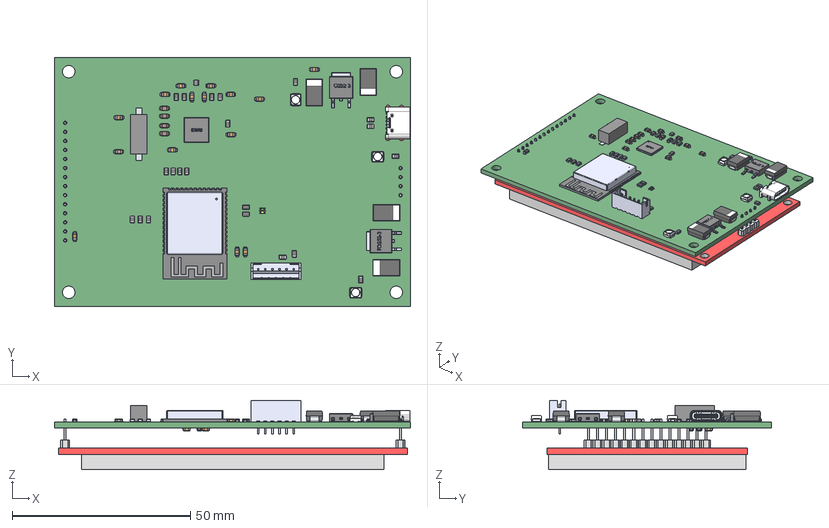
[picture p54: CAD file, 2026-01-11]
altium/TCC01_v2/PCB2_0.step
100.0 x 70.0 x 19.4 mm
User Library-0805 SMD Resistor x 21
Pins x 2
TO252-3 x 2
Package
Mark
Logo
PLCC-2 x 3
PLACA PCI
PinsArrayL
PinsArrayR
User Library-0805_Cap x 23
CAP-2312 x 4
