wellytomOC/TCC/(list of files, cad)

Other CAD files:
altium/TCC01_v2/PCB2_0/PCB2_0/6843147888.ipt
altium/TCC01_v2/PCB2_0/PCB2_0/6843150368.ipt
altium/TCC01_v2/PCB2_0/PCB2_0/6843150528.iam
altium/TCC01_v2/PCB2_0/PCB2_0/6843151728.iam
altium/TCC01_v2/PCB2_0/PCB2_0/89400-0610.ipt
altium/TCC01_v2/PCB2_0/PCB2_0/Board.iam
altium/TCC01_v2/PCB2_0/PCB2_0/Body.ipt
altium/TCC01_v2/PCB2_0/PCB2_0/Body_1.ipt
altium/TCC01_v2/PCB2_0/PCB2_0/C1.iam
altium/TCC01_v2/PCB2_0/PCB2_0/C10.iam
altium/TCC01_v2/PCB2_0/PCB2_0/C11.iam
altium/TCC01_v2/PCB2_0/PCB2_0/C13.iam
altium/TCC01_v2/PCB2_0/PCB2_0/C14.iam
altium/TCC01_v2/PCB2_0/PCB2_0/C15.iam
altium/TCC01_v2/PCB2_0/PCB2_0/C16.iam
altium/TCC01_v2/PCB2_0/PCB2_0/C17.iam
altium/TCC01_v2/PCB2_0/PCB2_0/C18.iam
altium/TCC01_v2/PCB2_0/PCB2_0/C19.iam
altium/TCC01_v2/PCB2_0/PCB2_0/C2.iam
altium/TCC01_v2/PCB2_0/PCB2_0/C20.iam
altium/TCC01_v2/PCB2_0/PCB2_0/C21.iam
altium/TCC01_v2/PCB2_0/PCB2_0/C22.iam
altium/TCC01_v2/PCB2_0/PCB2_0/C23.iam
altium/TCC01_v2/PCB2_0/PCB2_0/C24.iam
altium/TCC01_v2/PCB2_0/PCB2_0/C25.iam
altium/TCC01_v2/PCB2_0/PCB2_0/C26.iam
altium/TCC01_v2/PCB2_0/PCB2_0/C27.iam
altium/TCC01_v2/PCB2_0/PCB2_0/C28.iam
altium/TCC01_v2/PCB2_0/PCB2_0/C3.iam
altium/TCC01_v2/PCB2_0/PCB2_0/C4.iam
altium/TCC01_v2/PCB2_0/PCB2_0/C5.iam
altium/TCC01_v2/PCB2_0/PCB2_0/C6.iam
altium/TCC01_v2/PCB2_0/PCB2_0/C7.iam
altium/TCC01_v2/PCB2_0/PCB2_0/C8.iam
altium/TCC01_v2/PCB2_0/PCB2_0/C9.iam
altium/TCC01_v2/PCB2_0/PCB2_0/CAP-2312.ipt
altium/TCC01_v2/PCB2_0/PCB2_0/CN1.iam
altium/TCC01_v2/PCB2_0/PCB2_0/D1.iam
altium/TCC01_v2/PCB2_0/PCB2_0/D4.iam
altium/TCC01_v2/PCB2_0/PCB2_0/Fillet.ipt
altium/TCC01_v2/PCB2_0/PCB2_0/Fillet_1.ipt
altium/TCC01_v2/PCB2_0/PCB2_0/IC_Analog_Devices_AD5941BCPZ-RL7_eec.iam
altium/TCC01_v2/PCB2_0/PCB2_0/J1.iam
altium/TCC01_v2/PCB2_0/PCB2_0/LCD1.iam
altium/TCC01_v2/PCB2_0/PCB2_0/LD1.iam
altium/TCC01_v2/PCB2_0/PCB2_0/LD2.iam
altium/TCC01_v2/PCB2_0/PCB2_0/LD3.iam
altium/TCC01_v2/PCB2_0/PCB2_0/Logo.ipt
altium/TCC01_v2/PCB2_0/PCB2_0/Mark.ipt
altium/TCC01_v2/PCB2_0/PCB2_0/Open CASCADE STEP translator 7.5 1.1.1.ipt
altium/TCC01_v2/PCB2_0/PCB2_0/PCB2_0.iam
altium/TCC01_v2/PCB2_0/PCB2_0/PLACA PCI.ipt
altium/TCC01_v2/PCB2_0/PCB2_0/PLCC-2.ipt
altium/TCC01_v2/PCB2_0/PCB2_0/Package.ipt
altium/TCC01_v2/PCB2_0/PCB2_0/Pad.ipt
altium/TCC01_v2/PCB2_0/PCB2_0/Pad004.ipt
altium/TCC01_v2/PCB2_0/PCB2_0/Pad004_1.ipt
altium/TCC01_v2/PCB2_0/PCB2_0/Pad_1.ipt
altium/TCC01_v2/PCB2_0/PCB2_0/Pins.ipt
altium/TCC01_v2/PCB2_0/PCB2_0/PinsArrayL.ipt
altium/TCC01_v2/PCB2_0/PCB2_0/PinsArrayR.ipt
altium/TCC01_v2/PCB2_0/PCB2_0/Pins_1.ipt
altium/TCC01_v2/PCB2_0/PCB2_0/Pocket001.ipt
altium/TCC01_v2/PCB2_0/PCB2_0/Pocket001_1.ipt
altium/TCC01_v2/PCB2_0/PCB2_0/Pocket002.ipt
altium/TCC01_v2/PCB2_0/PCB2_0/Pocket002_1.ipt
altium/TCC01_v2/PCB2_0/PCB2_0/R1.iam
altium/TCC01_v2/PCB2_0/PCB2_0/R10.iam
altium/TCC01_v2/PCB2_0/PCB2_0/R11.iam
altium/TCC01_v2/PCB2_0/PCB2_0/R12.iam
altium/TCC01_v2/PCB2_0/PCB2_0/R13.iam
altium/TCC01_v2/PCB2_0/PCB2_0/R14.iam
altium/TCC01_v2/PCB2_0/PCB2_0/R15.iam
altium/TCC01_v2/PCB2_0/PCB2_0/R16.iam
altium/TCC01_v2/PCB2_0/PCB2_0/R17.iam
altium/TCC01_v2/PCB2_0/PCB2_0/R18.iam
altium/TCC01_v2/PCB2_0/PCB2_0/R19.iam
altium/TCC01_v2/PCB2_0/PCB2_0/R2.iam
altium/TCC01_v2/PCB2_0/PCB2_0/R20.iam
altium/TCC01_v2/PCB2_0/PCB2_0/R24.iam
altium/TCC01_v2/PCB2_0/PCB2_0/R25.iam
altium/TCC01_v2/PCB2_0/PCB2_0/R26.iam
altium/TCC01_v2/PCB2_0/PCB2_0/R3.iam
altium/TCC01_v2/PCB2_0/PCB2_0/R4.iam
altium/TCC01_v2/PCB2_0/PCB2_0/R5.iam
altium/TCC01_v2/PCB2_0/PCB2_0/R8.iam
altium/TCC01_v2/PCB2_0/PCB2_0/R9.iam
altium/TCC01_v2/PCB2_0/PCB2_0/TO252-3.ipt
altium/TCC01_v2/PCB2_0/PCB2_0/U1.iam
altium/TCC01_v2/PCB2_0/PCB2_0/U2.iam
altium/TCC01_v2/PCB2_0/PCB2_0/U3.iam
altium/TCC01_v2/PCB2_0/PCB2_0/U4.iam
altium/TCC01_v2/PCB2_0/PCB2_0/User Library-0805 SMD Resistor.ipt
altium/TCC01_v2/PCB2_0/PCB2_0/User Library-0805_Cap.ipt
altium/TCC01_v2/PCB2_0/PCB2_0/User Library-LED_0603_G.iam
altium/TCC01_v2/PCB2_0/PCB2_0/User Library-LED_0603_Y.iam
altium/TCC01_v2/PCB2_0/PCB2_0/Y1.iam
inventor/Jooj_V1/GABIENTE.ipt
inventor/Jooj_V1/OldVersions/GABIENTE.0010.ipt
inventor/wash/GabineteWash2.ipt
inventor/wash/gabineteWash.ipt
