wellytomOC/TCC/Figuras/Resultados/bk891.png

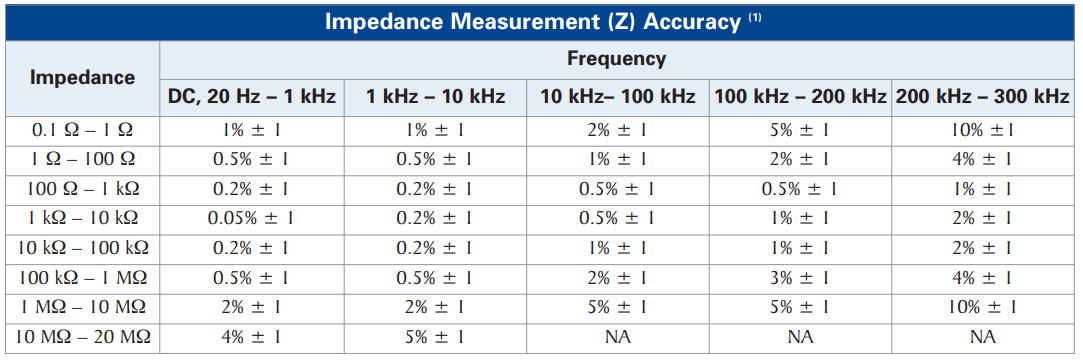
Figuras/Resultados/bk891.png
