wellytomOC/TCC/Figuras/Resultados/Cap4700uf.png

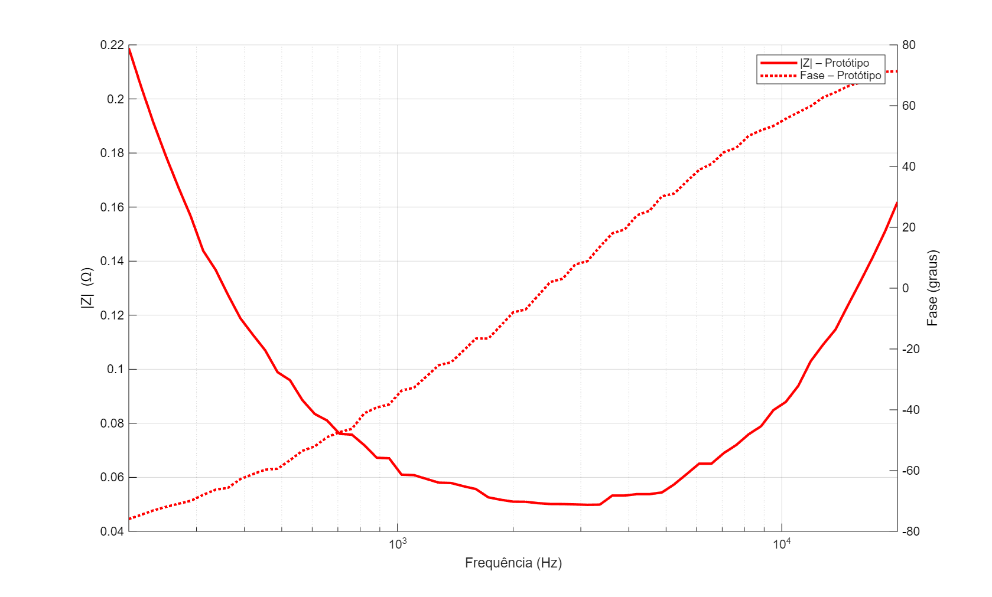
Figuras/Resultados/Cap4700uf.png
