wellytomOC/TCC/Figuras/Resultados/Figure_4.png

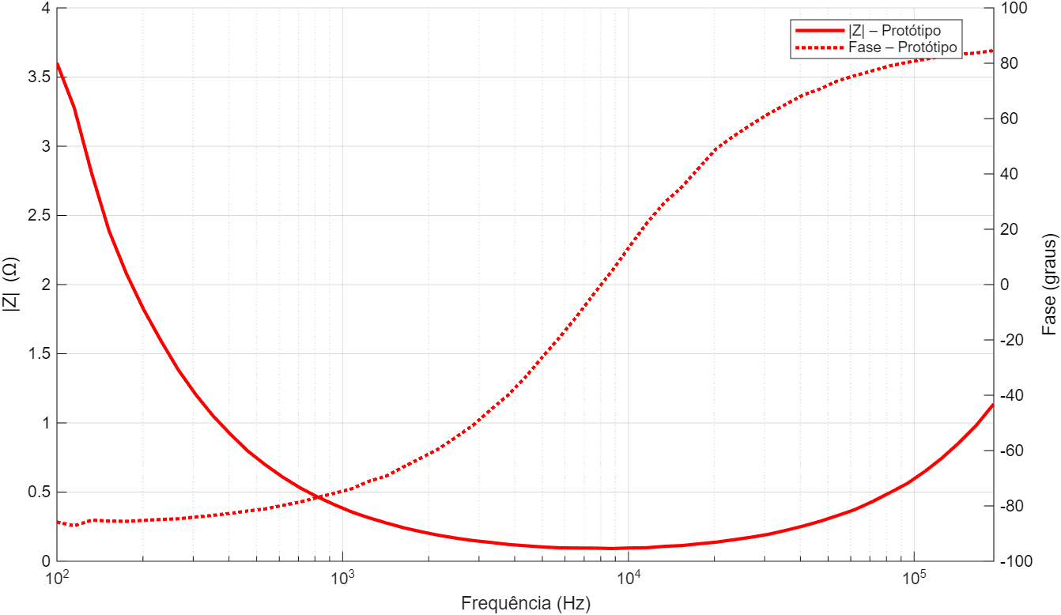
Figuras/Resultados/Figure_4.png
