wellytomOC/TCC/Figuras/Resultados/GrafResistores.png

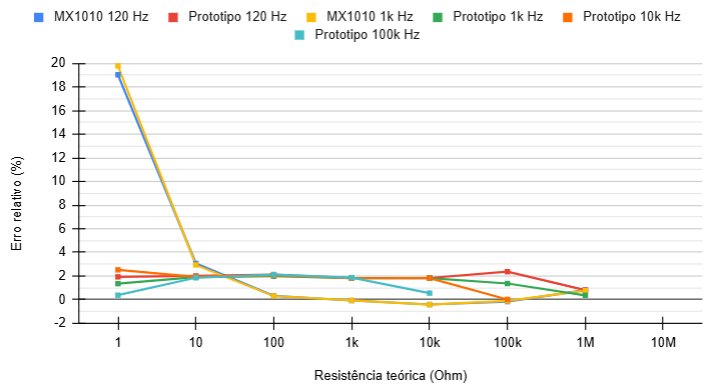
Figuras/Resultados/GrafResistores.png
