wellytomOC/TCC/Figuras/Resultados/Layout PCB.png

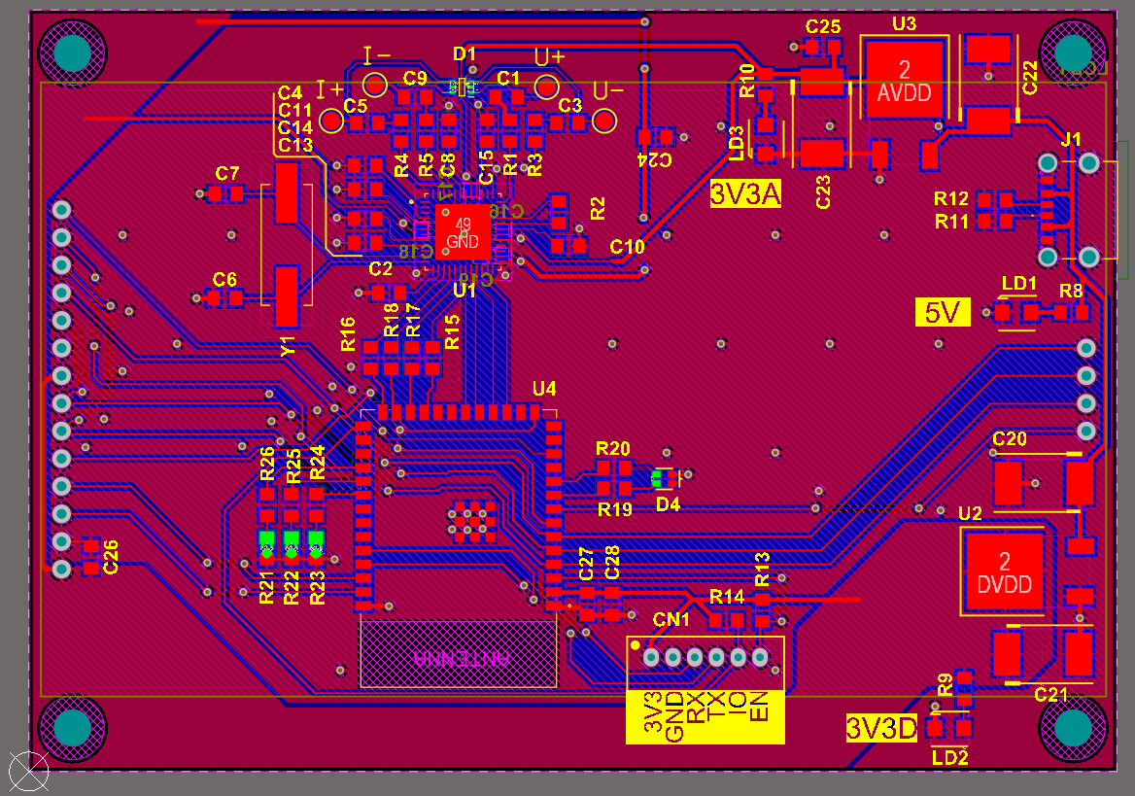
Figuras/Resultados/Layout PCB.png
