wellytomOC/TCC/altium/TCC01_v2/schematicsv2.pdf

# DECOUPLING CAPS

# ELETRODOS

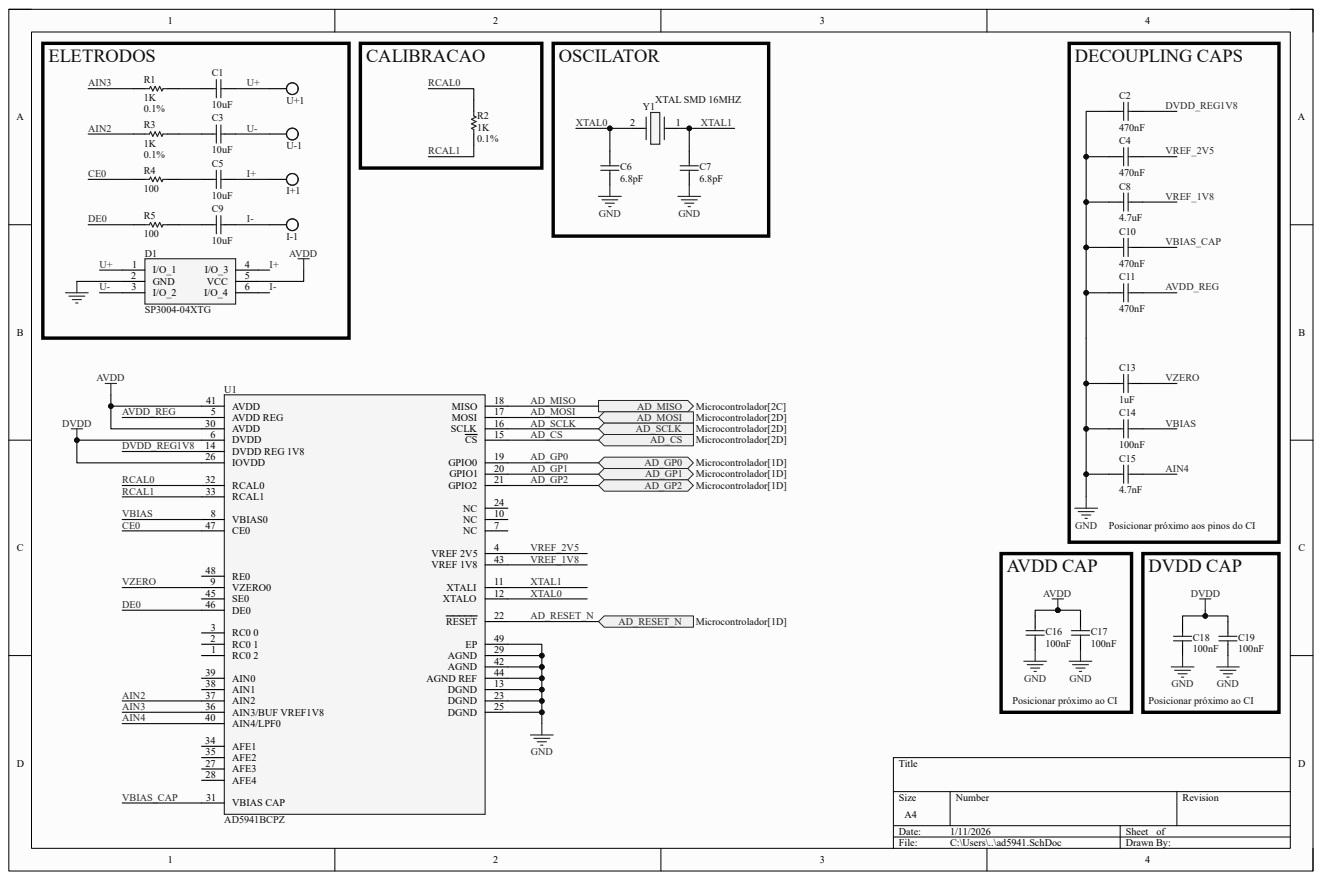
[picture p85: page 1]

Posicionar próximo aos pinos do CI
DVDD CAP

GND
Posicionar próximo ao CI

# LDO_DVDD

# LEDS

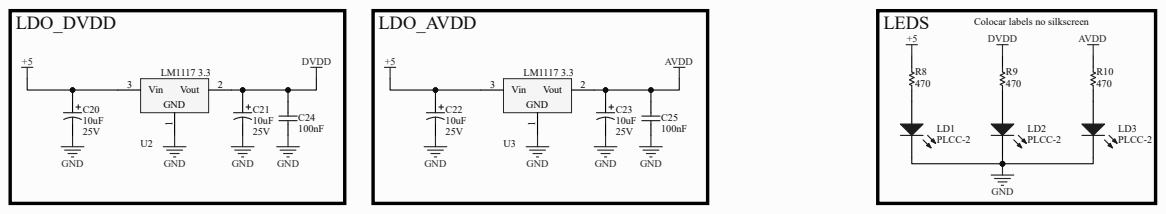
[picture p86: page 2]

Colocar labels no silkscreen

PROGRAMAÇÃO | USB | DISPLAY
DEBUGLED¹ | LED²

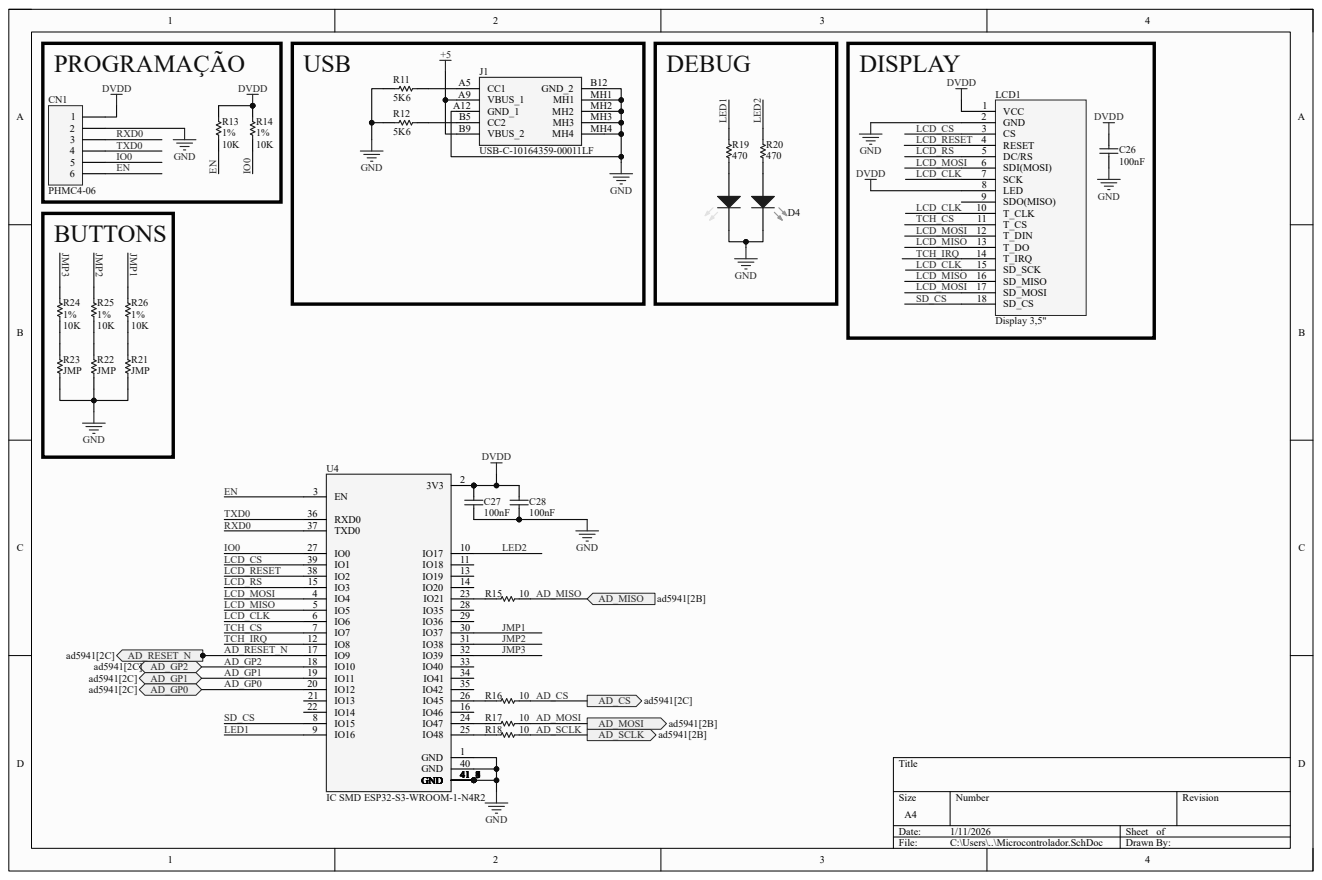
[picture p87: page 3]
