wellytomOC/TCC/Livros/LCR Meter Elektor 3 (1).pdf

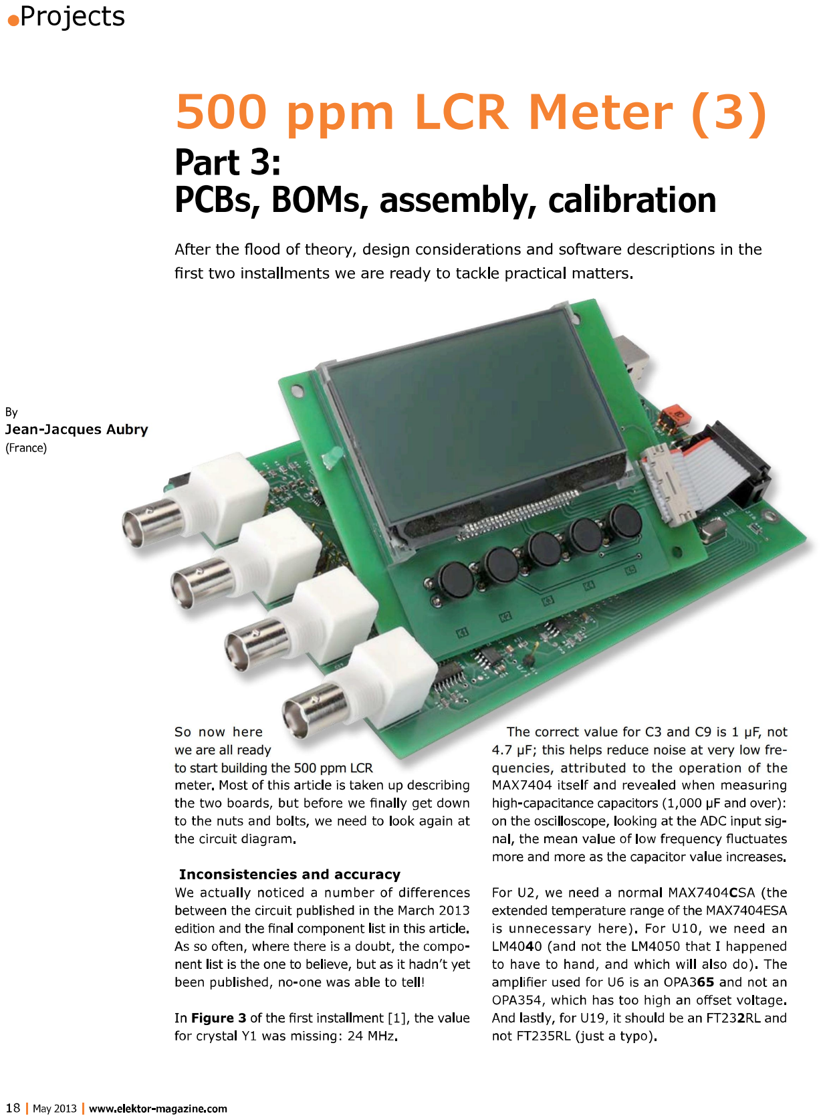
[picture p100: page 1]

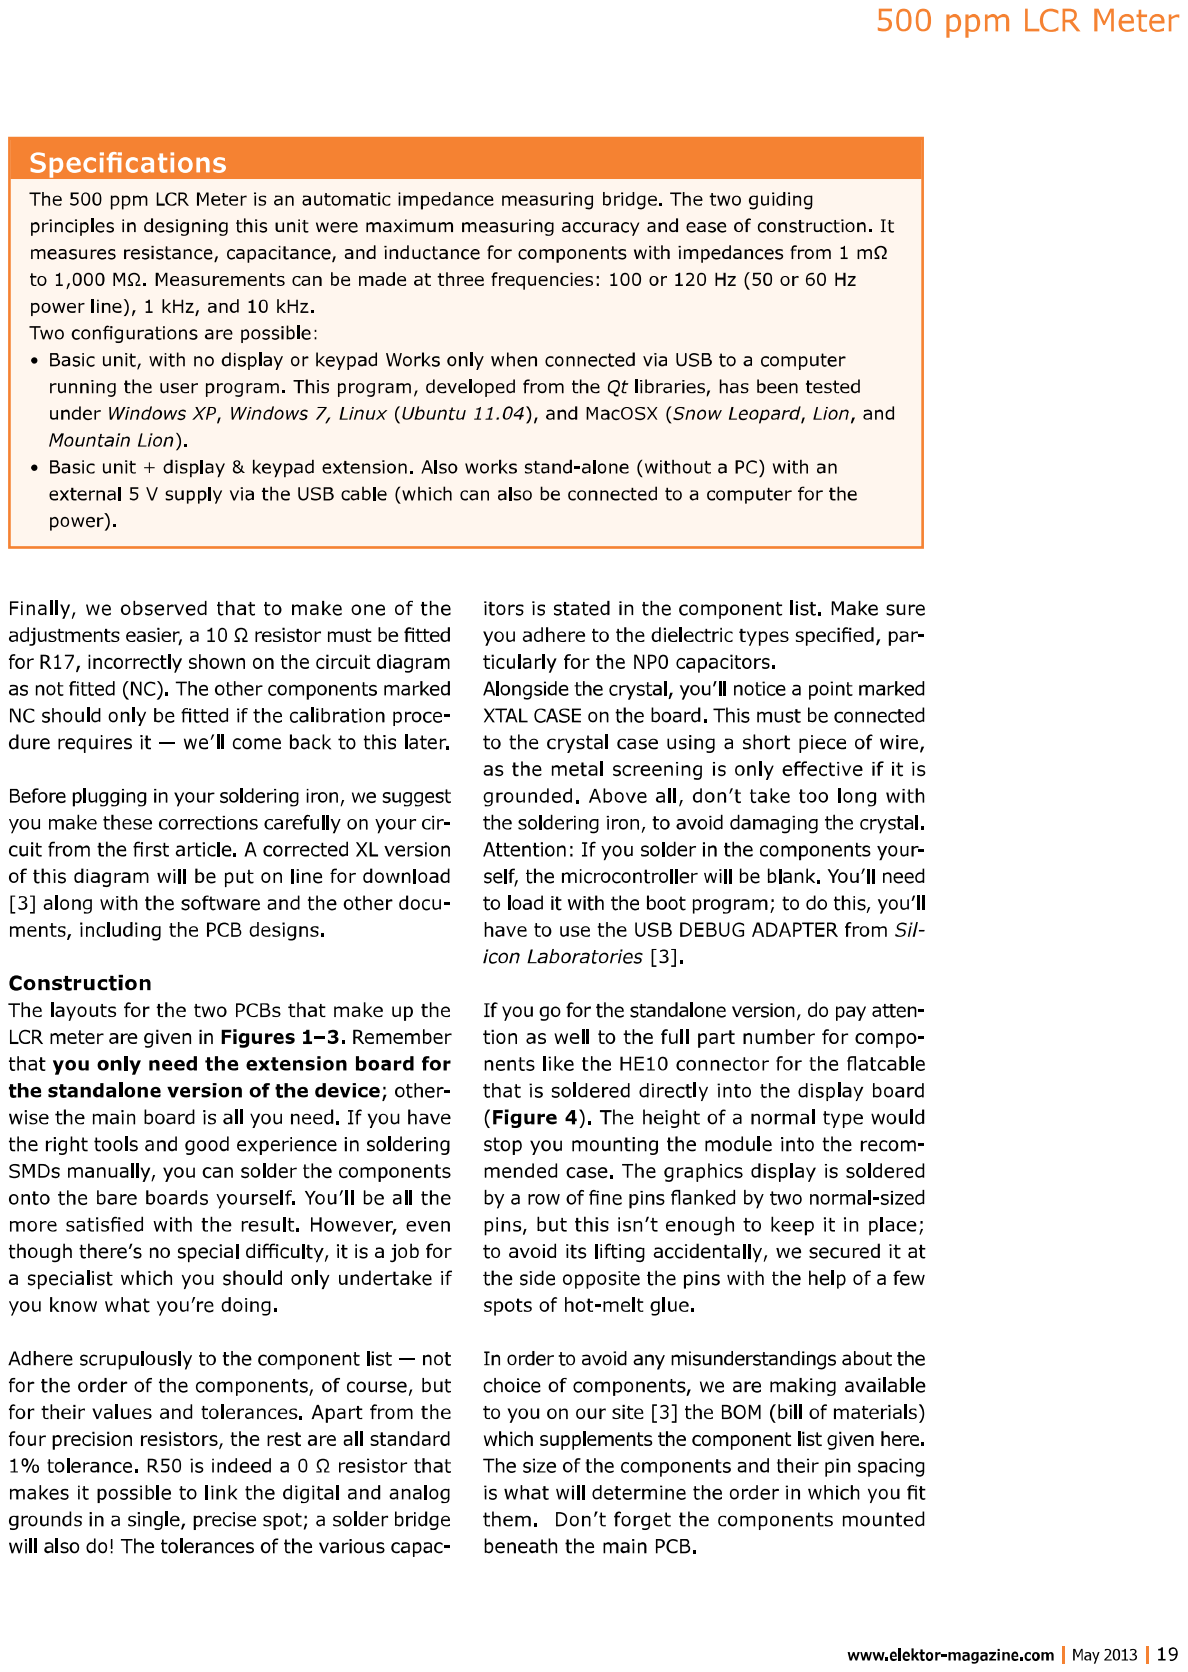
[picture p101: page 2]

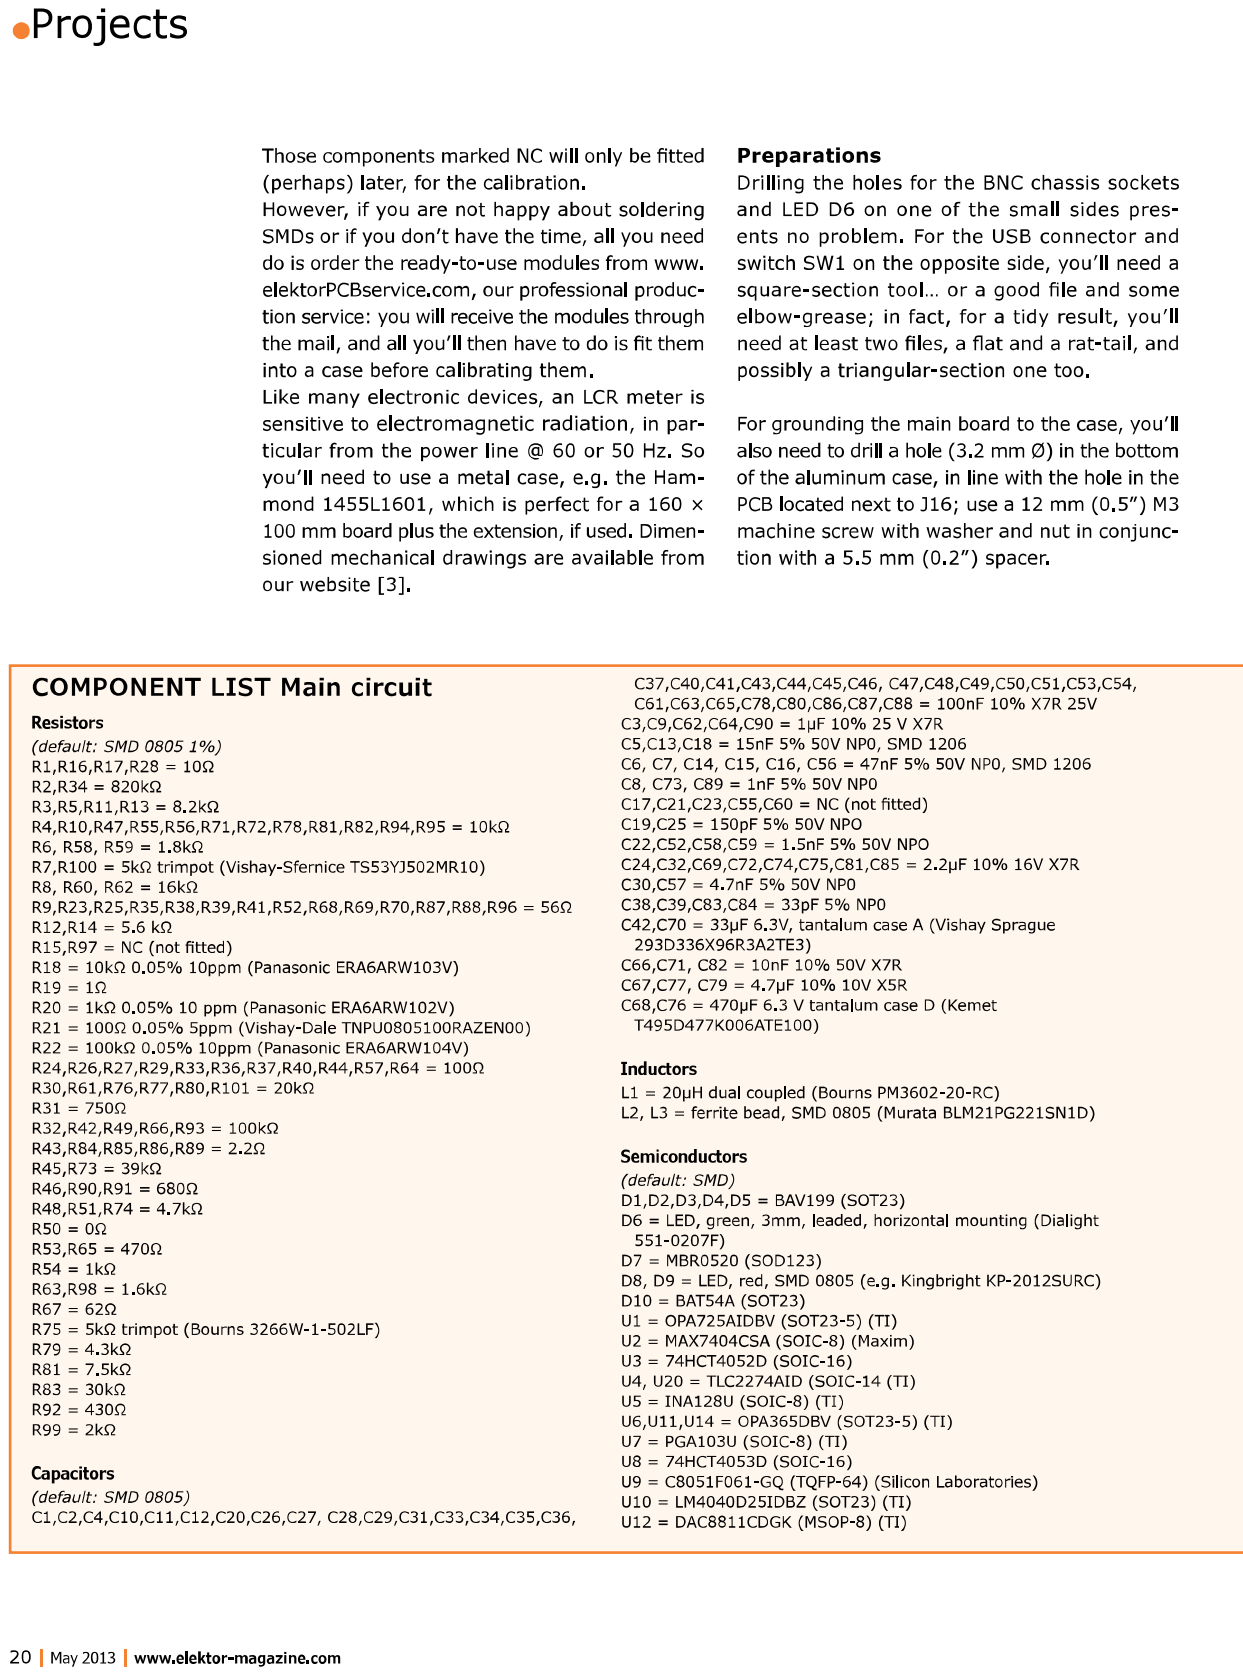
[picture p102: page 3]

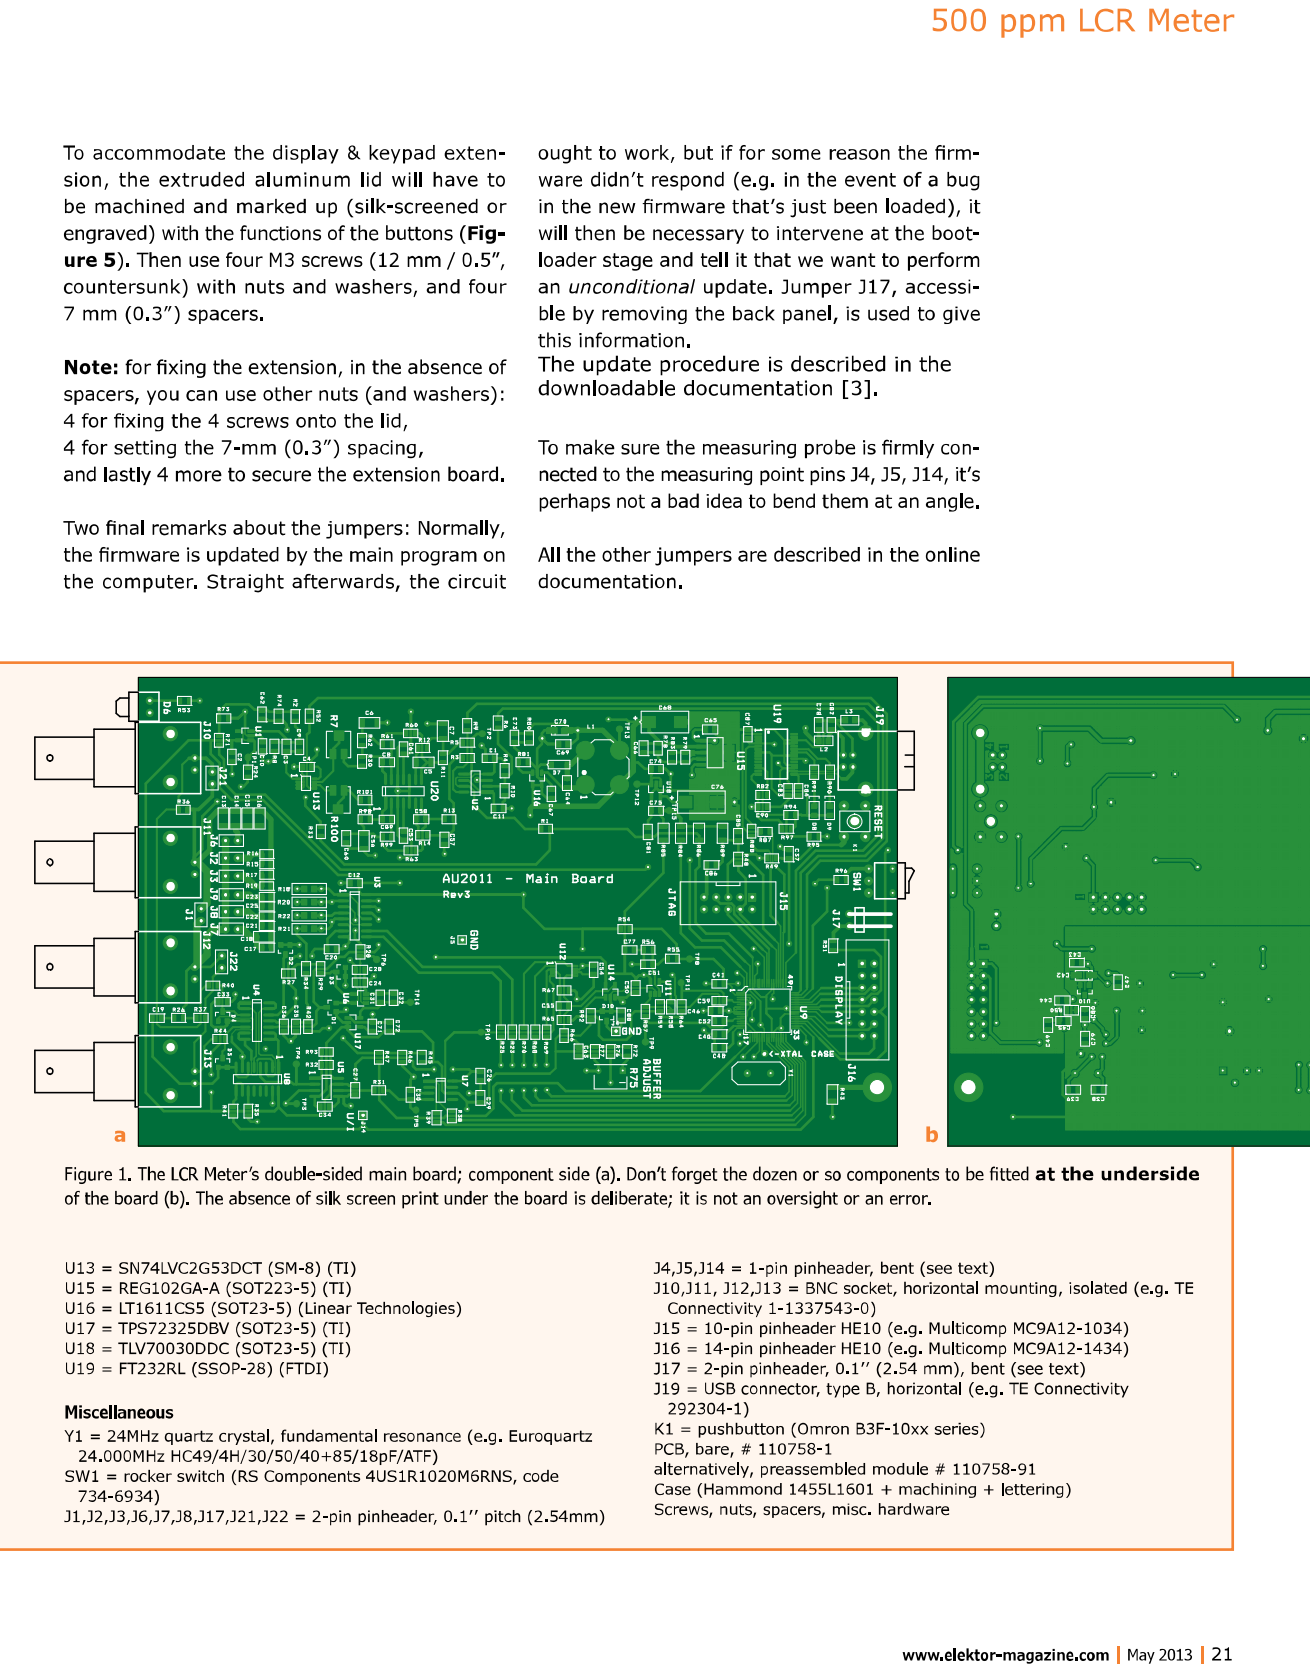
[picture p103: page 4]

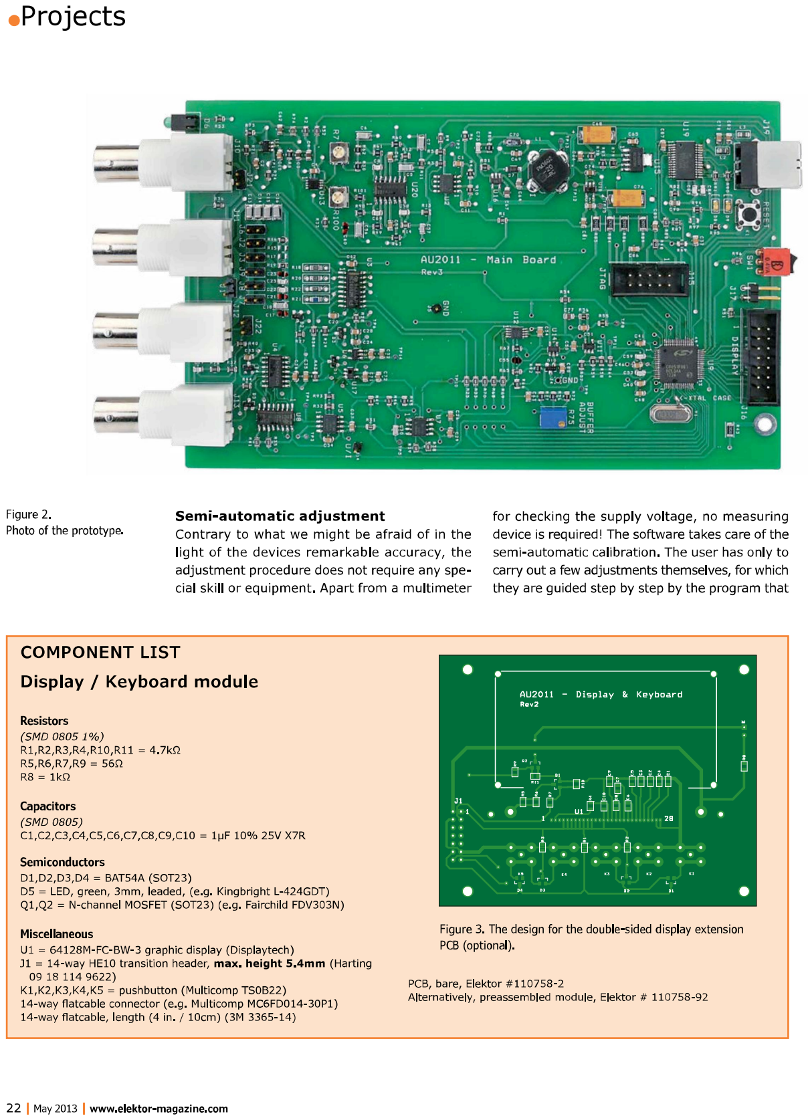
[picture p104: page 5]

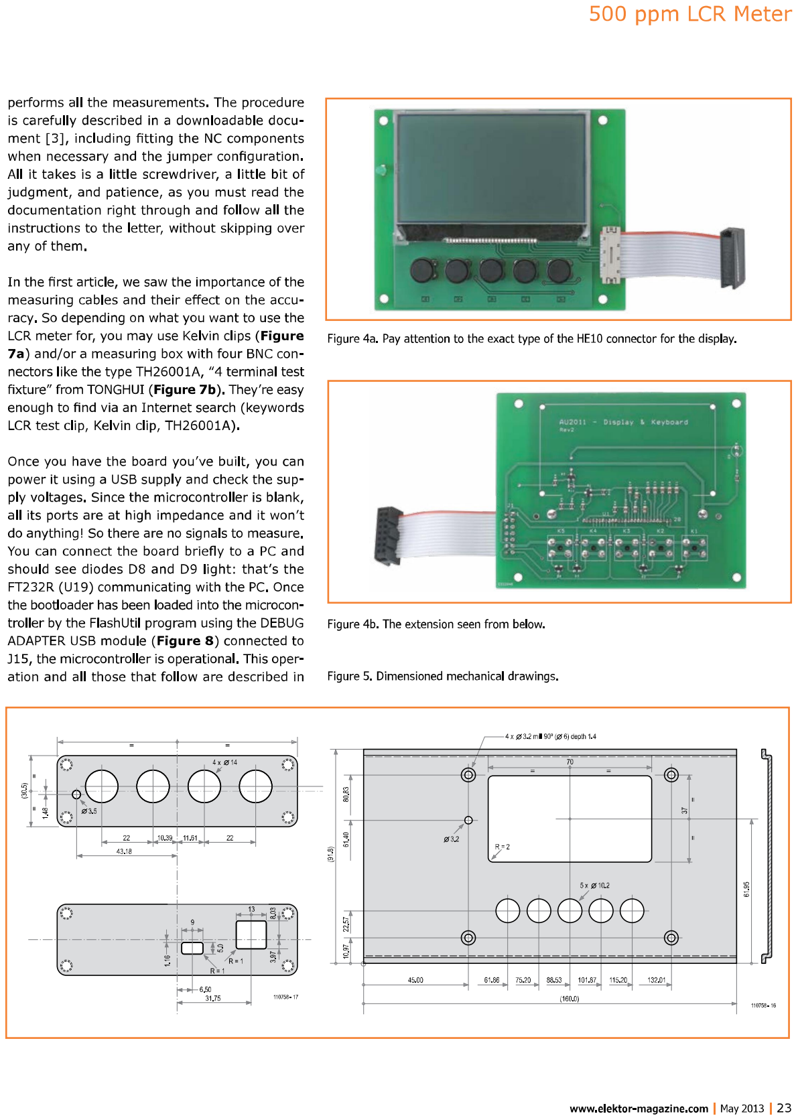
[picture p105: page 6]

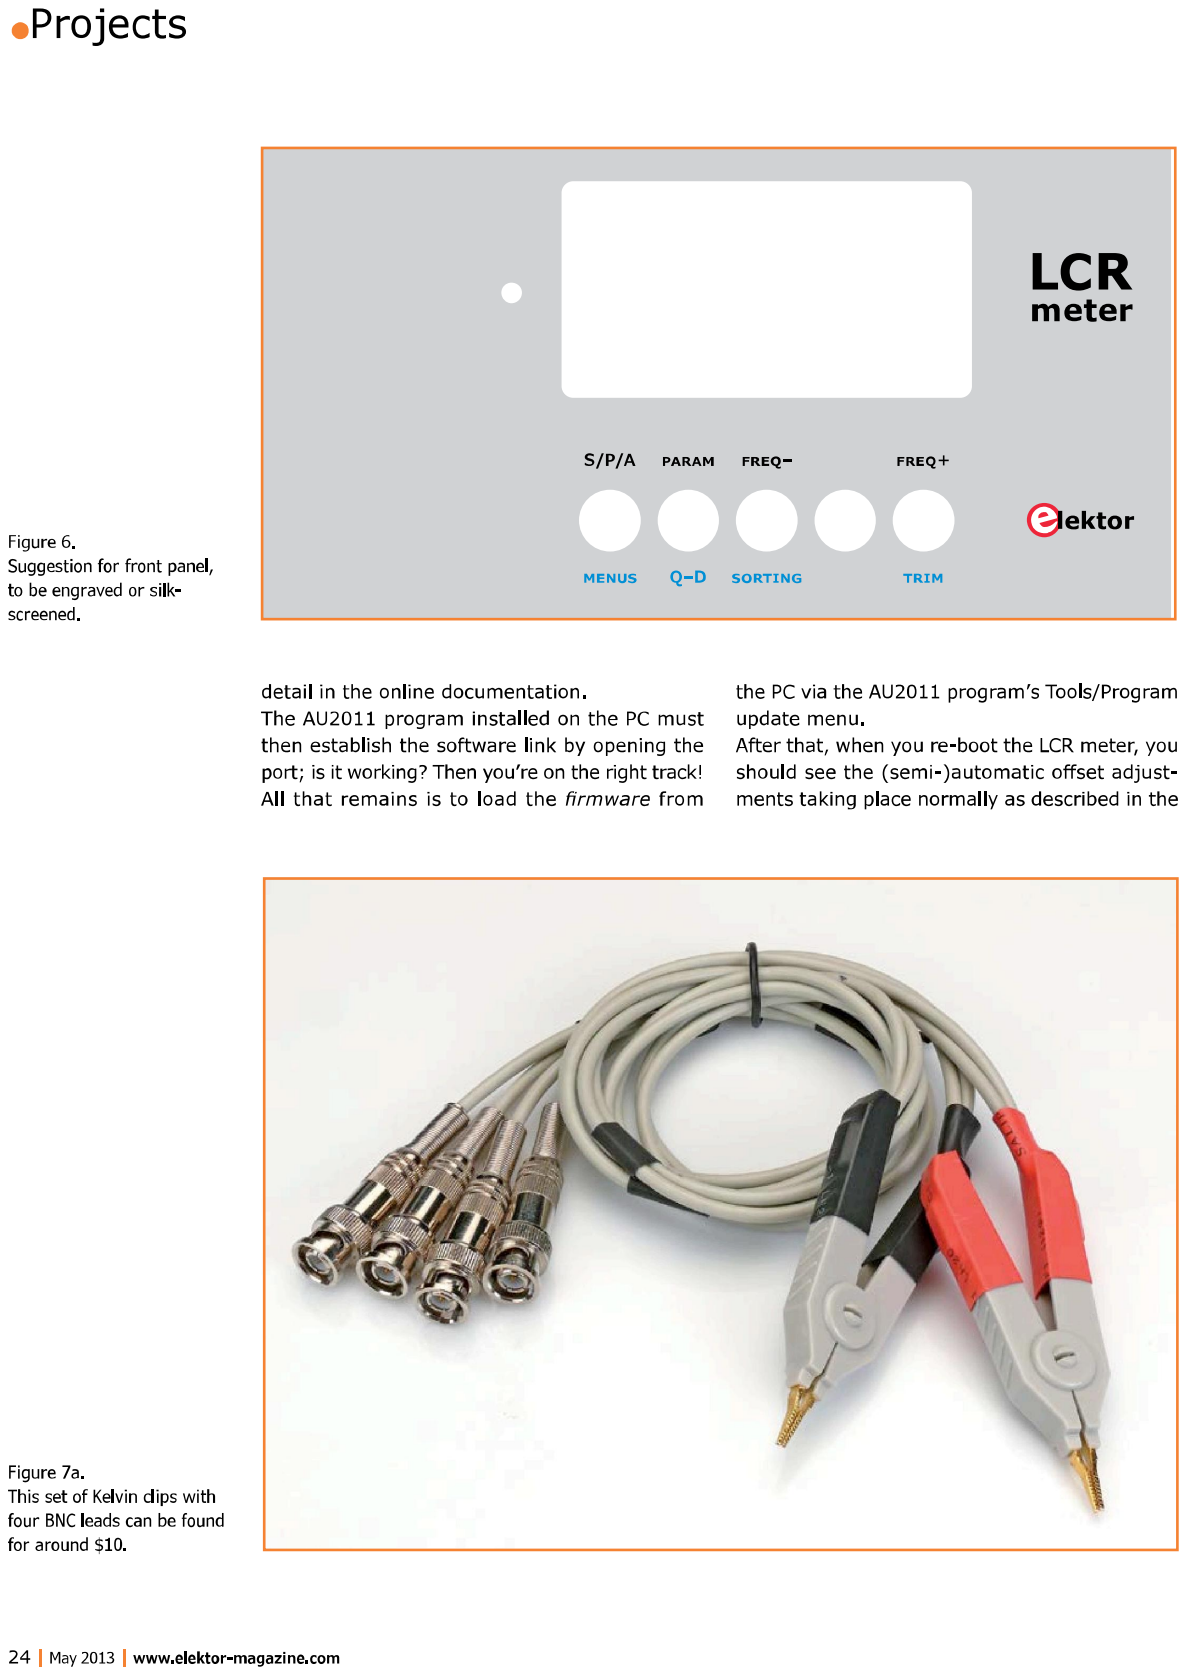
[picture p106: page 7]

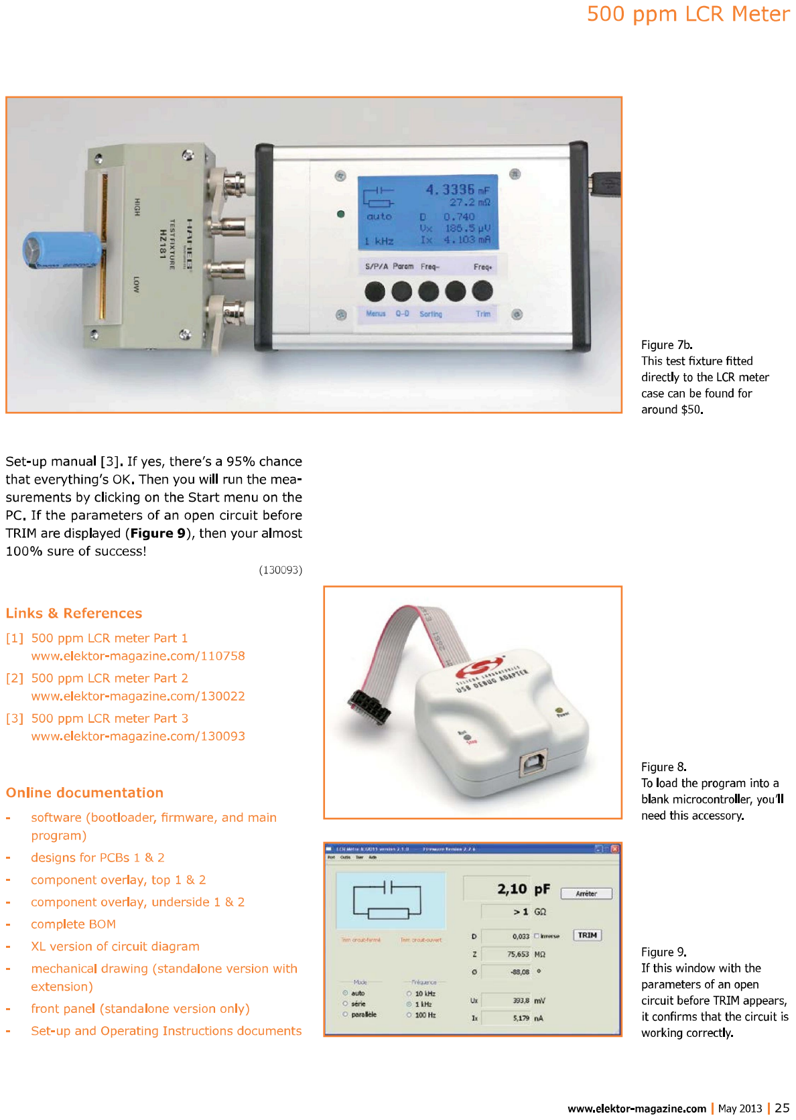
[picture p107: page 8]
