wellytomOC/TCC/altium/TCC01/schematics.pdf

# DECOUPLING CAPS

# ELETRODOS

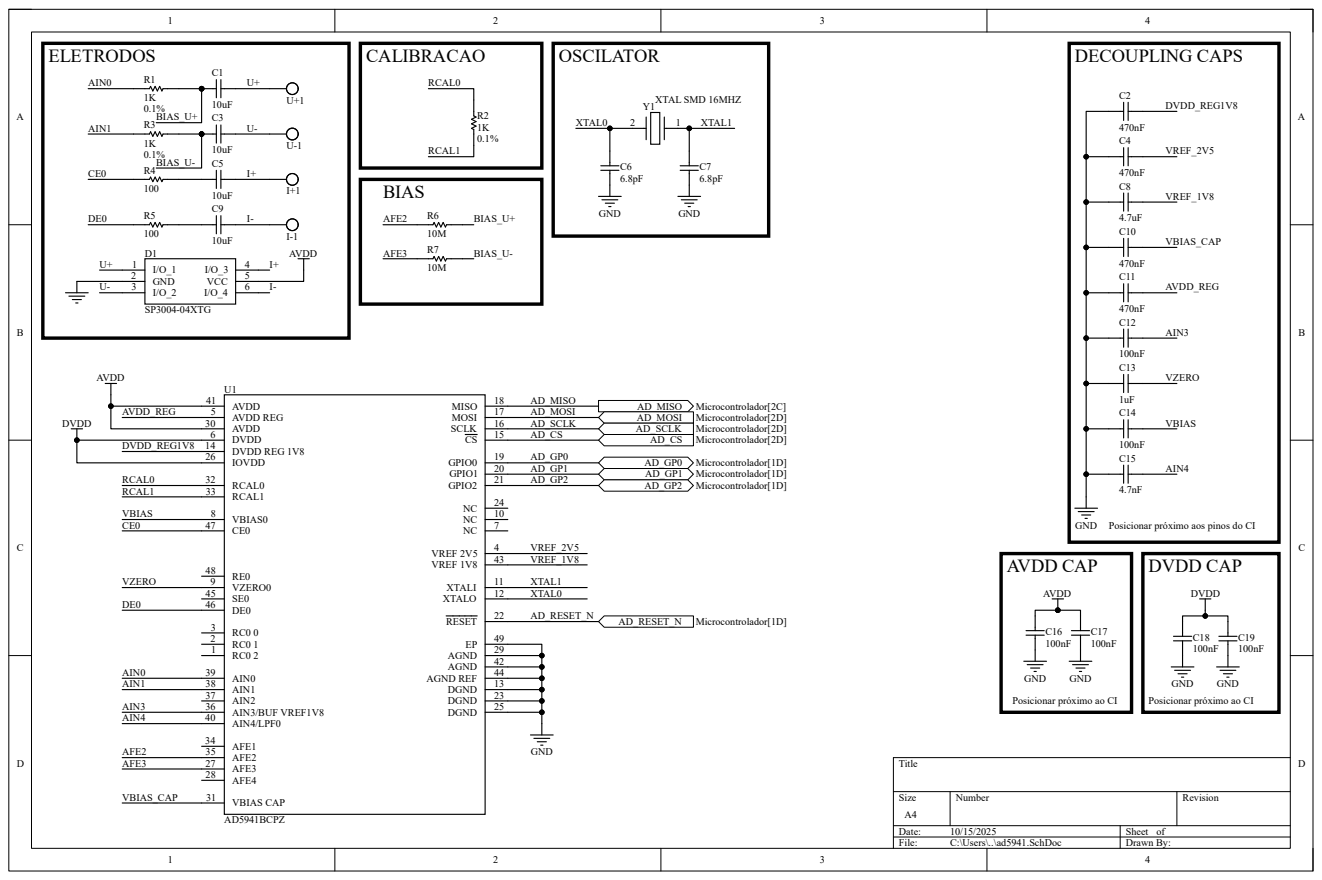
[picture p108: page 1]

Posicionar próximo aos pinos do CI
DVDD CAP

GND
Posicionar próximo ao CI

# LDO_DVDD

# LEDS

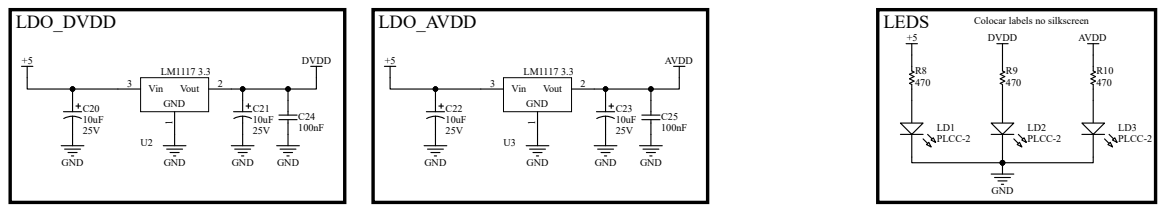
[picture p109: page 2]

Colocar labels no silkscreen

PROGRAMAÇÃO | USB | DISPLAY
DEBUGLED¹ | LED²

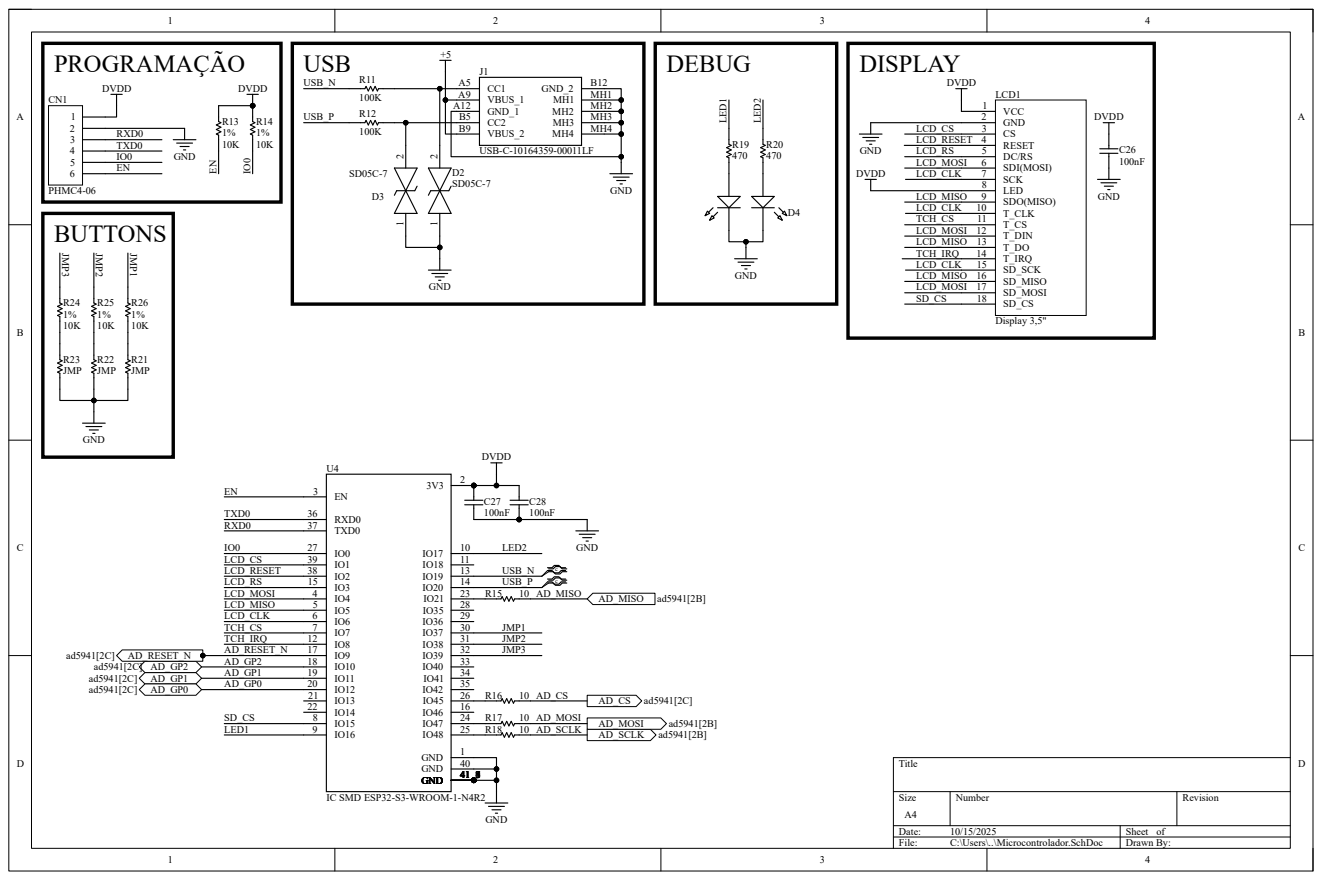
[picture p110: page 3]
