wellytomOC/TCC/simulacoes/teste sistema.asc

C1: cap; 10µ
C2: cap; 10µ
C3: cap; 10µ
C4: cap; 10µ
L1: ind; 300µ; Rser=10m
R1: res; 10
R2: res; 1k
R3: res; 1k
R4: res; 10
R5: res; 100
U1: opamp
V1: voltage; SINE(1.11 0.6 100)
Named nets: 0
.tran 100m
.lib opamp.sub
