wellytomOC/TCC/(list of files, drawings)

Other design files:
altium/TCC01_v2/ad5941.SchDoc
altium/TCC01_v2/alimentacao.SchDoc
altium/TCC01_v2/BIB SCH GERAL.SchLib
altium/TCC01_v2/Microcontrolador.SchDoc
altium/TCC01_v2/PCB2_0.PcbDoc
altium/TCC01_v2/TCC01.PrjPcb
Ref boards/LCR-master/LCR-master/hardware/Imported (1) LCR.PrjPcb/LCR.PcbDoc
Ref boards/LCR-master/LCR-master/hardware/Imported (1) LCR.PrjPcb/LCR.PrjPcb
Ref boards/LCR-master/LCR-master/hardware/Imported (1) LCR.PrjPcb/LCR_0.SchDoc
Ref boards/LCR-master/LCR-master/hardware/Imported (1) LCR.PrjPcb/LCR_1.SchDoc
Ref boards/LCR-master/LCR-master/hardware/Imported (1) LCR.PrjPcb/LCR_2.SchDoc
Ref boards/LCR-master/LCR-master/hardware/Imported LCR.PrjPcb/LCR.PcbDoc
Ref boards/LCR-master/LCR-master/hardware/Imported LCR.PrjPcb/LCR.PrjPcb
