wellytomOC/TCC/Ref boards/LCR-master/LCR-master/hardware/LCR.brd

## EAGLE design Ref boards/LCR-master/LCR-master/hardware/LCR.brd (2025-02-26)

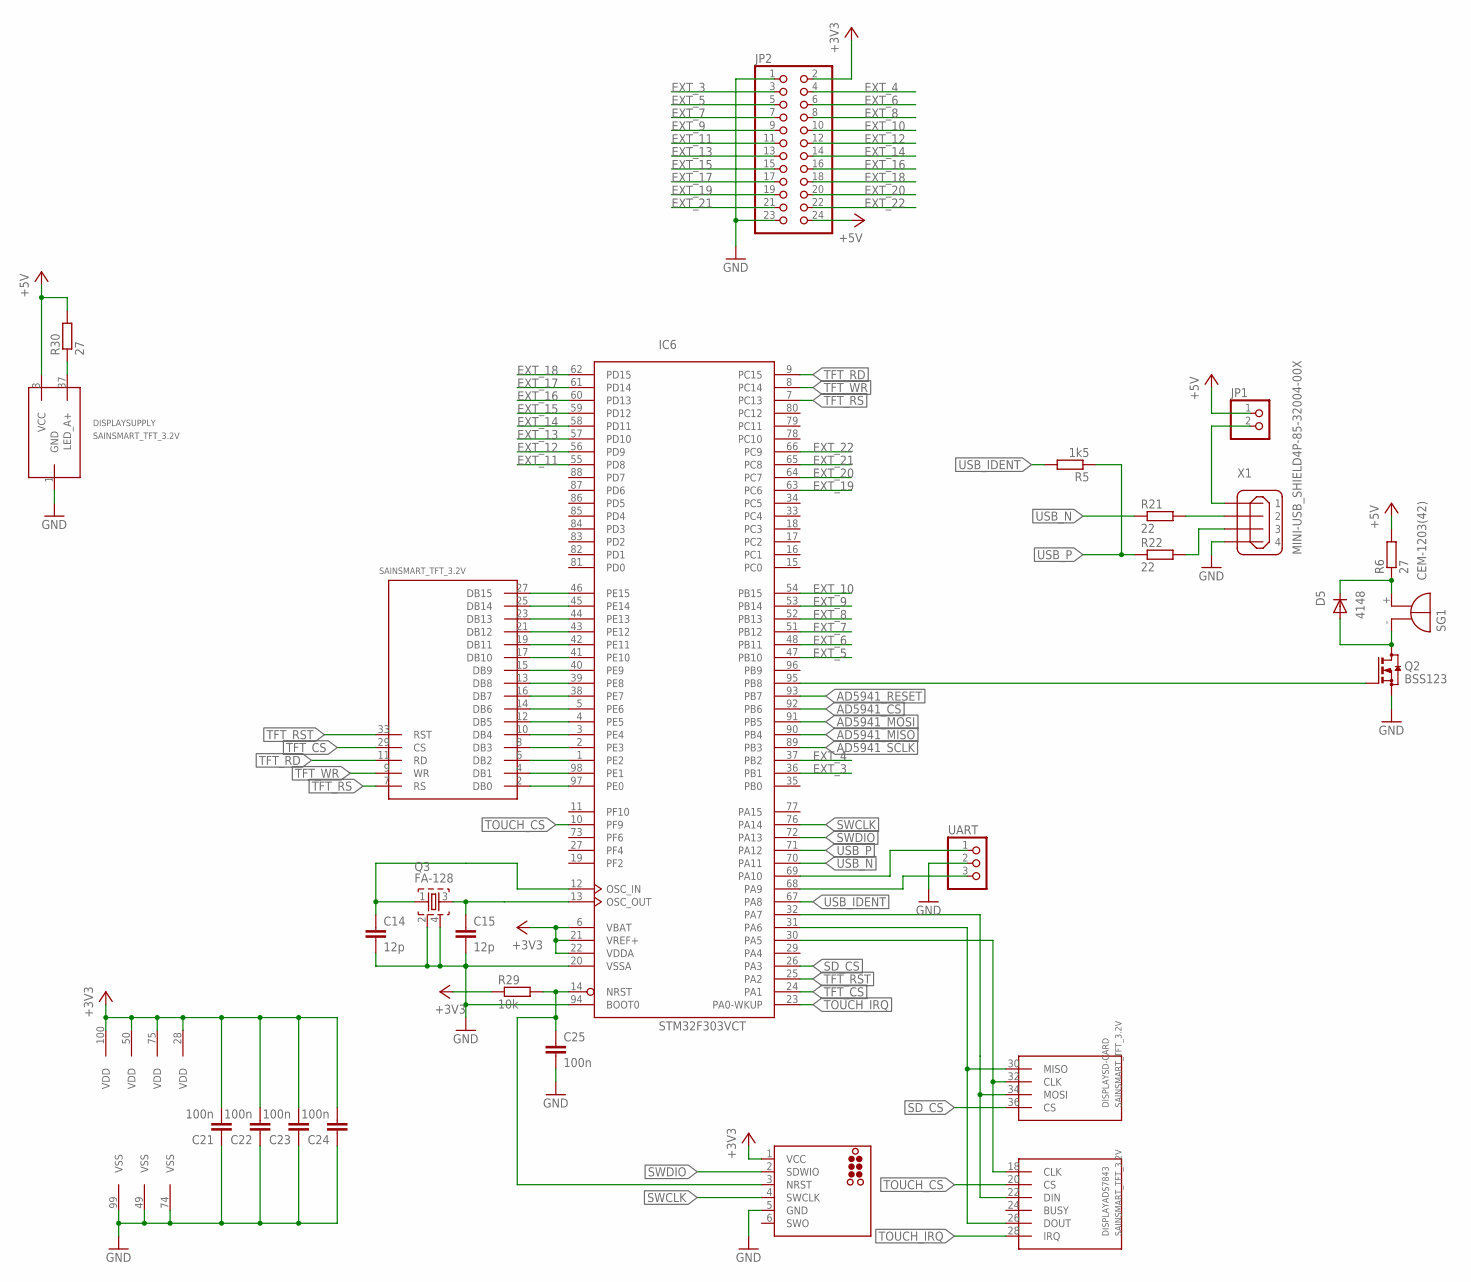
[picture p111: schematic LCR.sch, sheet 1]

Parts:
C14, C15: 12p; C0603K
C21, C22, C23, C24, C25: 100n; C0603K
D5: 4148; SOD123
DISPLAY: SAINSMART_TFT_3.2V; SAINSMART_ANGLED
IC6: STM32F303VCT; LQFP100
J1: TC2030-MCP
JP1: PINHD-1X2; 1X02
JP2: PINHD-2X12; 2X12
Q2: BSS123; SOT23
Q3: FA-128
R5: 1k5; R0603
R6, R30: 27; R1206
R21, R22: 22; R0603
R29: 10k; R0603
SG1: CEM-1203(42); F/QMBIII
UART: PINHD-1X3; 1X03
X1: MINI-USB_SHIELD4P-85-32004-00X; 85-32004-00X

Connections:
+3V3: C21.2, C22.2, C23.2, C24.2, IC6.6 (VBAT), IC6.21 (VREF+), IC6.22 (VDDA), IC6.28 (VDD), IC6.50 (VDD), IC6.75 (VDD), IC6.100 (VDD), J1.1 (VCC), JP2.2, R29.1; also elsewhere on the board
+5V: DISPLAY.3 (VCC), JP1.1, JP2.24, R6.2, R30.2; also elsewhere on the board
AD5941_CS: IC6.92 (PB6); also elsewhere on the board
AD5941_MISO: IC6.90 (PB4); also elsewhere on the board
AD5941_MOSI: IC6.91 (PB5); also elsewhere on the board
AD5941_RESET: IC6.93 (PB7); also elsewhere on the board
AD5941_SCLK: IC6.89 (PB3); also elsewhere on the board
EXT_3: IC6.36 (PB1), JP2.3
EXT_4: IC6.37 (PB2), JP2.4
EXT_5: IC6.47 (PB10), JP2.5
EXT_6: IC6.48 (PB11), JP2.6
EXT_7: IC6.51 (PB12), JP2.7
EXT_8: IC6.52 (PB13), JP2.8
EXT_9: IC6.53 (PB14), JP2.9
EXT_10: IC6.54 (PB15), JP2.10
EXT_11: IC6.55 (PD8), JP2.11
EXT_12: IC6.56 (PD9), JP2.12
EXT_13: IC6.57 (PD10), JP2.13
EXT_14: IC6.58 (PD11), JP2.14
EXT_15: IC6.59 (PD12), JP2.15
EXT_16: IC6.60 (PD13), JP2.16
EXT_17: IC6.61 (PD14), JP2.17
EXT_18: IC6.62 (PD15), JP2.18
EXT_19: IC6.63 (PC6), JP2.19
EXT_20: IC6.64 (PC7), JP2.20
EXT_21: IC6.65 (PC8), JP2.21
EXT_22: IC6.66 (PC9), JP2.22
GND: C14.2, C15.2, C21.1, C22.1, C23.1, C24.1, C25.2, DISPLAY.1 (GND), IC6.20 (VSSA), IC6.49 (VSS), IC6.74 (VSS), IC6.94 (BOOT0), IC6.99 (VSS), J1.5 (GND), JP2.1, JP2.23, Q2.2 (S), Q3.2, Q3.4, UART.2, X1.4; also elsewhere on the board
unnamed: IC6.95 (PB8), Q2.1 (G)
unnamed: DISPLAY.2 (DB0), IC6.97 (PE0)
unnamed: DISPLAY.4 (DB1), IC6.98 (PE1)
unnamed: DISPLAY.6 (DB2), IC6.1 (PE2)
unnamed: DISPLAY.8 (DB3), IC6.2 (PE3)
unnamed: DISPLAY.22 (DIN), DISPLAY.34 (MOSI), IC6.32 (PA7)
unnamed: DISPLAY.10 (DB4), IC6.3 (PE4)
unnamed: DISPLAY.12 (DB5), IC6.4 (PE5)
unnamed: DISPLAY.14 (DB6), IC6.5 (PE6)
unnamed: DISPLAY.16 (DB7), IC6.38 (PE7)
unnamed: DISPLAY.26 (DOUT), DISPLAY.30 (MISO), IC6.31 (PA6)
unnamed: DISPLAY.18 (CLK), DISPLAY.32 (CLK), IC6.30 (PA5)
unnamed: C14.1, IC6.12 (OSC_IN), Q3.1
unnamed: C15.1, IC6.13 (OSC_OUT), Q3.3
unnamed: R21.2, X1.2
unnamed: R22.2, X1.3
unnamed: C25.1, IC6.14 (NRST), J1.3 (NRST), R29.2
unnamed: DISPLAY.37 (LED_A+), R30.1
unnamed: DISPLAY.13 (DB8), IC6.39 (PE8)
unnamed: DISPLAY.15 (DB9), IC6.40 (PE9)
unnamed: DISPLAY.17 (DB10), IC6.41 (PE10)
unnamed: DISPLAY.19 (DB11), IC6.42 (PE11)
unnamed: JP1.2, X1.1
unnamed: D5.C, R6.1, SG1.+ (-)
unnamed: DISPLAY.21 (DB12), IC6.43 (PE12)
unnamed: DISPLAY.23 (DB13), IC6.44 (PE13)
unnamed: DISPLAY.25 (DB14), IC6.45 (PE14)
unnamed: DISPLAY.27 (DB15), IC6.46 (PE15)
unnamed: D5.A, Q2.3 (D), SG1.- (+)
RX: IC6.69 (PA10), UART.1
SD_CS: DISPLAY.36 (CS), IC6.26 (PA3)
SWCLK: IC6.76 (PA14), J1.4 (SWCLK)
SWDIO: IC6.72 (PA13), J1.2 (SDWIO)
TFT_CS: DISPLAY.29 (CS), IC6.24 (PA1)
TFT_RD: DISPLAY.11 (RD), IC6.9 (PC15)
TFT_RS: DISPLAY.7 (RS), IC6.7 (PC13)
TFT_RST: DISPLAY.33 (RST), IC6.25 (PA2)
TFT_WR: DISPLAY.9 (WR), IC6.8 (PC14)
TOUCH_CS: DISPLAY.20 (CS), IC6.10 (PF9)
TOUCH_IRQ: DISPLAY.28 (IRQ), IC6.23 (PA0-WKUP)
TX: IC6.68 (PA9), UART.3
USB_IDENT: IC6.67 (PA8), R5.2
USB_N: IC6.70 (PA11), R21.1
USB_P: IC6.71 (PA12), R5.1, R22.1

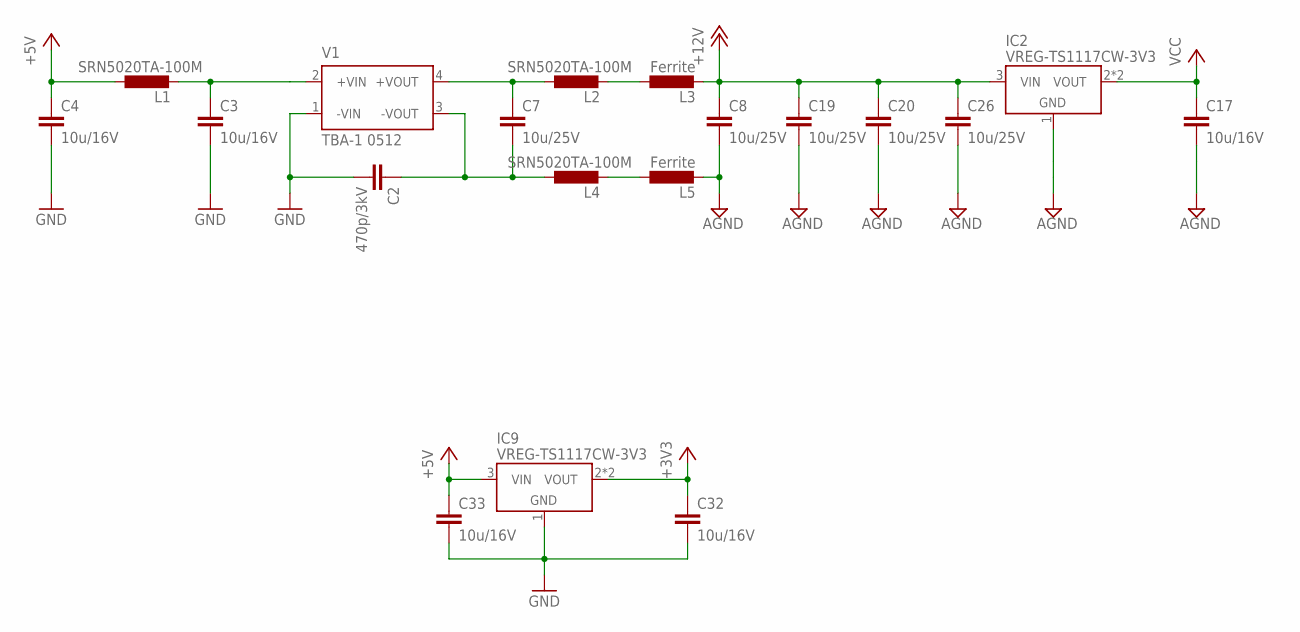
[picture p112: schematic LCR.sch, sheet 2]

Parts:
C2: 470p/3kV; C1812
C3, C4, C17, C32, C33: 10u/16V; C1206K
C7, C8, C19, C20, C26: 10u/25V; C1206K
IC2, IC9: VREG-TS1117CW-3V3; SOT223
L1, L2, L4: SRN5020TA-100M; SRN5040
L3, L5: Ferrite; R0603
V1: TBA-1 0512; TME

Connections:
+3V3: C32.1, IC9.2 (VOUT), IC9.4 (VOUT); also elsewhere on the board
+5V: C4.1, C33.1, IC9.3 (VIN), L1.P$1 (1); also elsewhere on the board
+12V: C8.1, C19.1, C20.1, C26.1, IC2.3 (VIN), L3.2; also elsewhere on the board
AGND: C8.2, C17.2, C19.2, C20.2, C26.2, IC2.1 (GND), L5.2; also elsewhere on the board
GND: C2.2, C3.2, C4.2, C32.2, C33.2, IC9.1 (GND), V1.1 (-VIN); also elsewhere on the board
unnamed: C3.1, L1.P$2 (2), V1.2 (+VIN)
unnamed: C7.1, L2.P$1 (1), V1.4 (+VOUT)
unnamed: C2.1, C7.2, L4.P$1 (1), V1.3 (-VOUT)
unnamed: L2.P$2 (2), L3.1
unnamed: L4.P$2 (2), L5.1
VCC: C17.1, IC2.2 (VOUT), IC2.4 (VOUT); also elsewhere on the board

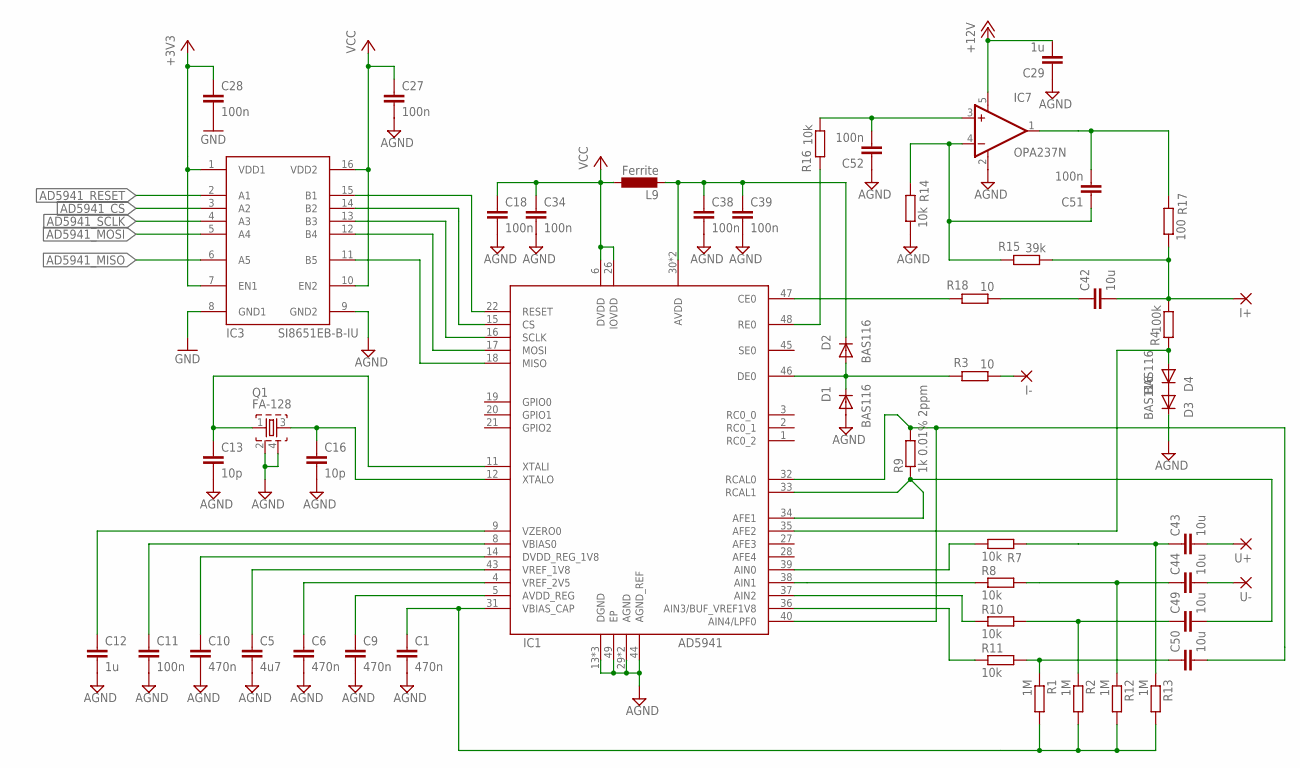
[picture p113: schematic LCR.sch, sheet 3]

Parts:
C1, C6, C9, C10: 470n; C0603K
C5: 4u7; C0603K
C11, C18, C27, C28, C34, C38, C39, C51, C52: 100n; C0603K
C12, C29: 1u; C0603K
C13, C16: 10p; C0603K
C42, C43, C44, C49, C50: 10u; C1206K
D1, D2, D3, D4: BAS116; SOD123
I+: 2,54/1,1
I-: 2,54/1,1
IC1: AD5941; QFN50P700X700X80-49T510N
IC3: SI8651EB-B-IU; SOP63P600X175-16N
IC7: OPA237N; SOT23-5
L9: Ferrite; R0603
Q1: FA-128
R1, R2, R12, R13: 1M; R0603
R3, R18: 10; R0603
R4: 100k; R0603
R7, R8, R10, R11, R14, R16: 10k; R0603
R9: 1k 0.01% 2ppm; M0805
R15: 39k; R0603
R17: 100; R0603
U+: 2,54/1,1
U-: 2,54/1,1

Connections:
+3V3: C28.1, IC3.1 (VDD1), IC3.7 (EN1); also elsewhere on the board
+12V: C29.2, IC7.5 (V+); also elsewhere on the board
AD5941_CS: IC3.3 (A2); also elsewhere on the board
AD5941_MISO: IC3.6 (A5); also elsewhere on the board
AD5941_MOSI: IC3.5 (A4); also elsewhere on the board
AD5941_RESET: IC3.2 (A1); also elsewhere on the board
AD5941_SCLK: IC3.4 (A3); also elsewhere on the board
AGND: C1.2, C5.2, C6.2, C9.2, C10.2, C11.2, C12.2, C13.2, C16.2, C18.2, C27.2, C29.1, C34.2, C38.2, C39.2, C52.1, D1.A, D3.C, IC1.13 (DGND), IC1.23 (DGND), IC1.25 (DGND), IC1.29 (AGND), IC1.42 (AGND), IC1.44 (AGND_REF), IC1.49 (EP), IC3.9 (GND2), IC7.2 (V-), Q1.2, Q1.4, R14.1; also elsewhere on the board
GND: C28.2, IC3.8 (GND1); also elsewhere on the board
I+: C42.2, I+.1, R4.1, R15.1, R17.1
I-: I-.1, R3.1
unnamed: C1.1, IC1.31 (VBIAS_CAP), R1.2, R2.2, R12.2, R13.2
unnamed: C6.1, IC1.4 (VREF_2V5)
unnamed: C5.1, IC1.43 (VREF_1V8)
unnamed: C9.1, IC1.5 (AVDD_REG)
unnamed: C10.1, IC1.14 (DVDD_REG_1V8)
unnamed: C11.1, IC1.8 (VBIAS0)
unnamed: C12.1, IC1.9 (VZERO0)
unnamed: C16.1, IC1.12 (XTALO), Q1.3
unnamed: C13.1, IC1.11 (XTALI), Q1.1
unnamed: IC1.17 (MOSI), IC3.12 (B4)
unnamed: C42.1, R18.1
unnamed: IC1.22 (RESET), IC3.15 (B1)
unnamed: IC1.15 (CS), IC3.14 (B2)
unnamed: IC1.16 (SCLK), IC3.13 (B3)
unnamed: IC1.18 (MISO), IC3.11 (B5)
unnamed: C38.1, C39.1, D2.C, IC1.30 (AVDD), IC1.41 (AVDD), L9.2
unnamed: IC1.47 (CE0), R18.2
unnamed: IC1.39 (AIN0), R7.1
unnamed: IC1.38 (AIN1), R8.1
unnamed: C44.1, R8.2, R12.1
unnamed: C43.1, R7.2, R13.1
unnamed: C49.2, IC1.33 (RCAL1), IC1.34 (AFE1), R9.1
unnamed: IC1.37 (AIN2), R10.1
unnamed: IC1.36 (AIN3/BUF_VREF1V8), R11.1
unnamed: C50.1, R1.1, R11.2
unnamed: C49.1, R2.1, R10.2
unnamed: IC1.48 (RE0), R16.2
unnamed: C52.2, IC7.3 (+IN), R16.1
unnamed: C51.1, IC7.4 (-IN), R14.2, R15.2
unnamed: C51.2, IC7.1 (OUT), R17.2
unnamed: D1.C, D2.A, IC1.46 (DE0), R3.2
unnamed: D4.A, IC1.35 (AFE2), R4.2
unnamed: D3.A, D4.C
unnamed: C50.2, IC1.32 (RCAL0), IC1.40 (AIN4/LPF0), R9.2
U+: C43.2, U+.1
U-: C44.2, U-.1
VCC: C18.1, C27.1, C34.1, IC1.6 (DVDD), IC1.26 (IOVDD), IC3.10 (EN2), IC3.16 (VDD2), L9.1; also elsewhere on the board

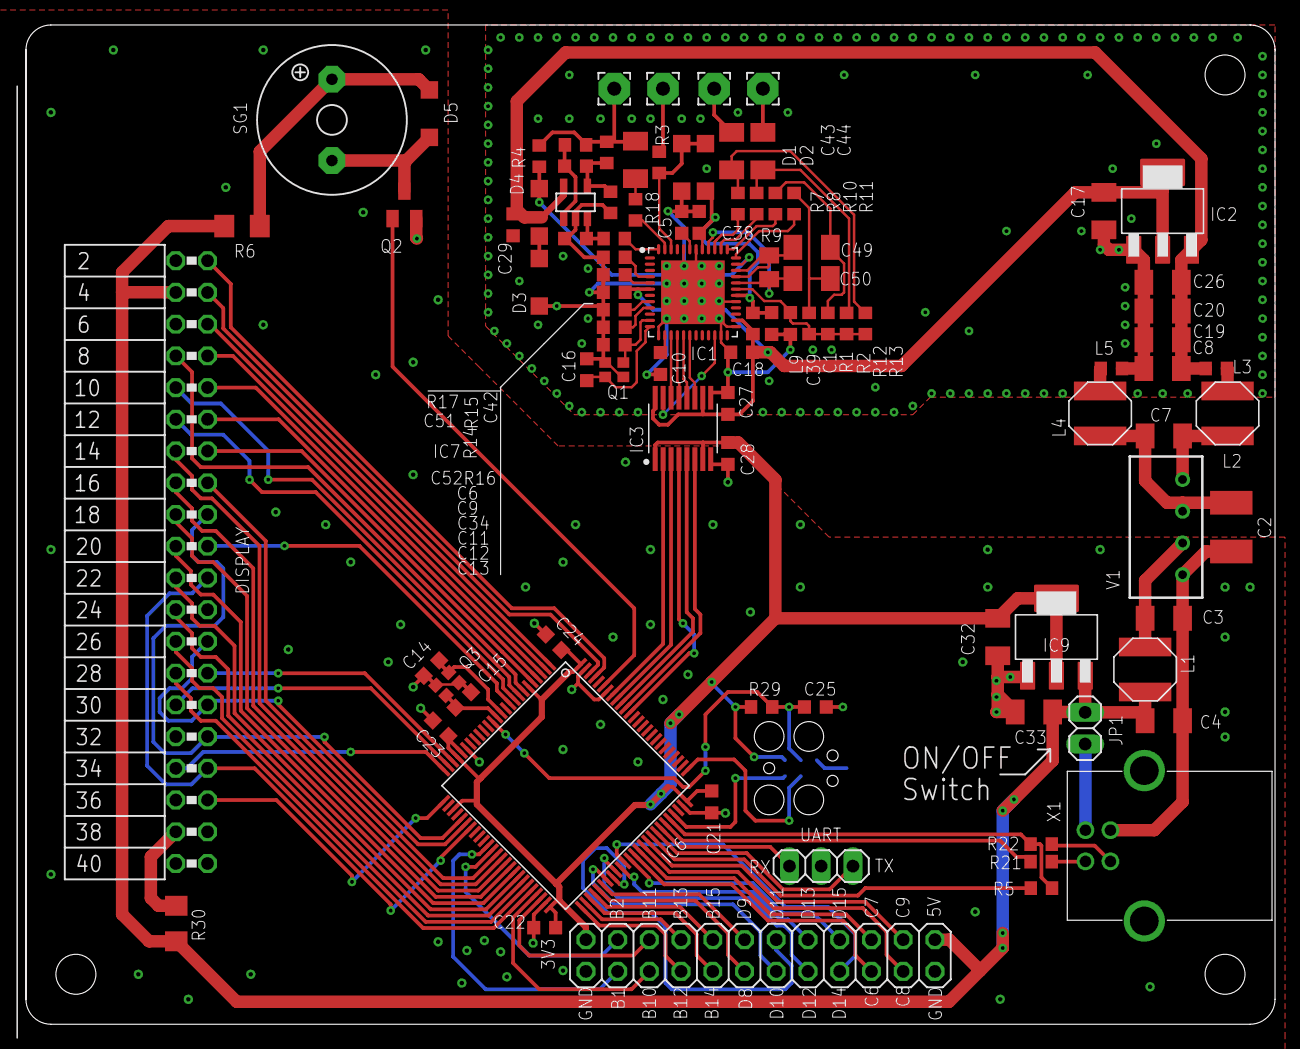
[picture p114: board LCR.brd from above]

Board: 2 copper layers, 100.0 x 80.0 mm, 95 parts (1 on the bottom side), 118 nets.
