wellytomOC/TCC/(commit log)

2025-02-27 adiciona TVS no altium
    [BIB SCH GERAL.SchLib, Microcontrolador.SchDoc, ad5941.SchDoc]
2025-03-13 spi meio que funciona
2025-03-24 ainda meio que funciona
2025-05-22 ajustes no sch
    [LCR_2.SchDoc, Microcontrolador.SchDoc, TCC01.PrjPcb, ad5941.SchDoc, alimentacao.SchDoc]
2025-05-31 nova pcb em desenvolvimento
    [Microcontrolador.SchDoc, PCB2_0.PcbDoc, TCC01.PrjPcb, ad5941.SchDoc, alimentacao.SchDoc]
2025-06-03 PCB V2 FINALIZADA
    [BIB SCH GERAL.SchLib, Microcontrolador.SchDoc, TCC01.PrjPcb]
2025-09-24 blabla tcc01
    [Microcontrolador.SchDoc]
2025-09-27 le 1 resistencia
2025-10-01 tem que ver esses pinos ai
2025-10-18 adc le certo quando tiro os jacares
2025-10-24 precisa testar leitura do ADC
2025-10-28 integrado lpdac com ADC
    Por alguma razao, o PGA calibration tem que ser feito DEPOIS que o LPDac foi inicializado
2025-11-04 adiciona tela de parametros. Precisa melhorar pq ta bem lenta
2025-11-07 grafico ta melhor, mas crasha e estoura memoria
    [main.cpp, main.h, screen_parameters.cpp]
2026-01-11 varias figuras no tcc e criei uma copia do altium pra arrumar o que foi errado
    [BIB SCH GERAL.SchLib, LCR.PcbDoc, Microcontrolador.SchDoc, PCB1.PcbDoc, PCB2_0.PcbDoc, TCC01.PrjPcb, ad5941.SchDoc, alimentacao.SchDoc]
2026-01-11 ajustes no schematicos e desenho do gabinete
    [GABIENTE.0009.ipt, GABIENTE.ipt, GabineteWash2.ipt, Microcontrolador.SchDoc, PCB1.PcbDoc, PCB2_0.PcbDoc, PCB2_0.step, TCC01.PrjPcb]
2026-03-05 trabalhando nos resultados - resistores foi
2026-03-18 agora tem case. Secao sobre IHM finalizada
2026-03-22 resultados quase pronto
    [TCC01.PrjPcb, leitura_001_2026-03-20_17-47-14.csv, leitura_001_2026-03-20_17-49-39.csv, leitura_001_470uH_47uF.csv, leitura_002_2026-03-20_17-08-11.csv, leitura_002_2026-03-20_17-50-21.csv, leitura_002_470uH_4p7uF_1kOhm.csv, leitura_003_220uH_4p7uF.csv]
2026-03-22 Terminei tudo AAAA Calma la
2026-05-23 Final final
    [leitura_001_2026-05-10_11-02-53.csv, leitura_00X_2026-05-10_11-02-53.csv]
